JeanSOUDIER/PRG_GE2_HC/Mecanique/Vues/Sside2.JPG

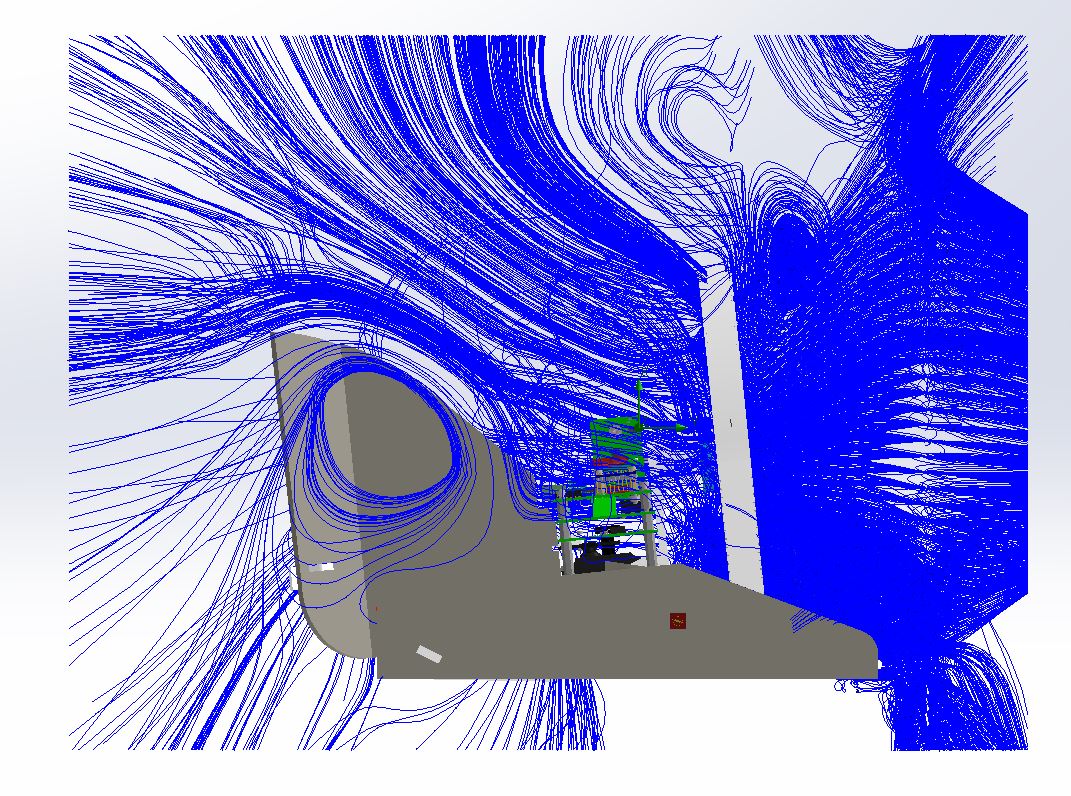
Mecanique/Vues/Sside2.JPG
