JeanSOUDIER/PRG_GE2_HC/Mecanique/Vues/poid.JPG

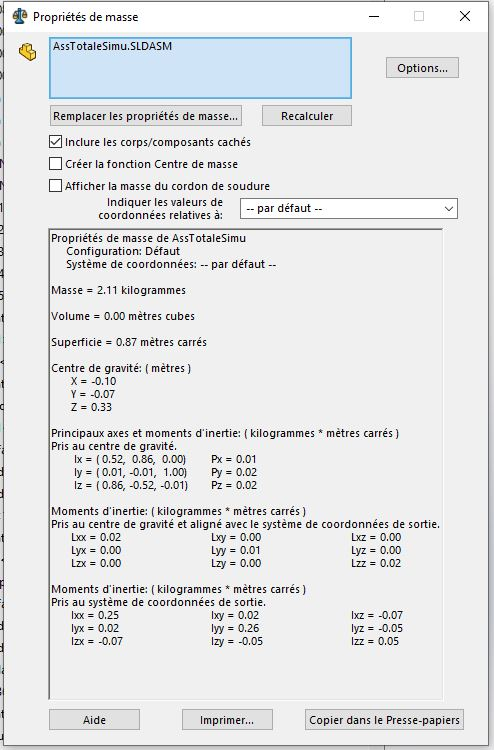
Mecanique/Vues/poid.JPG
