JeanSOUDIER/PRG_GE2_HC/Application/BackEnd1.PNG

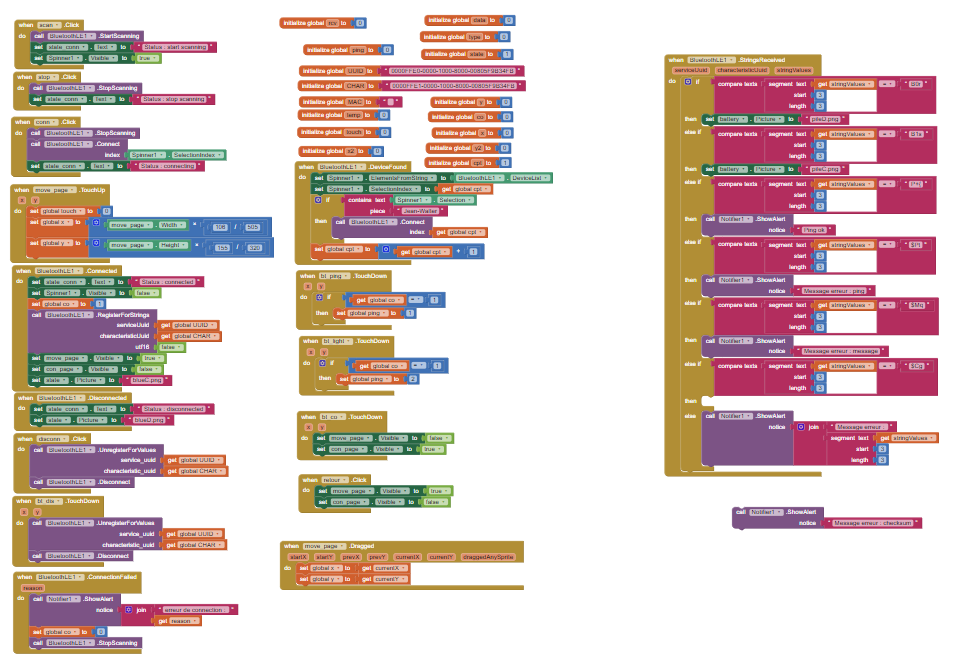
Application/BackEnd1.PNG
