JeanSOUDIER/PRG_GE2_HC/Application/BackEnd2.PNG

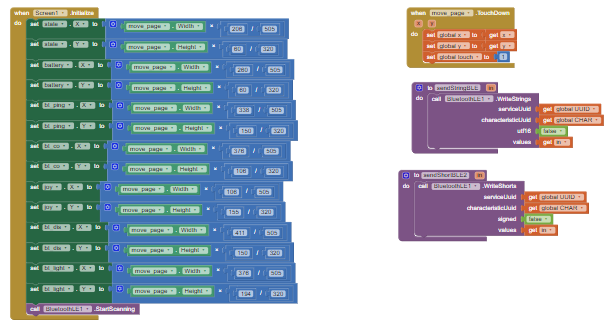
Application/BackEnd2.PNG
