JeanSOUDIER/PRG_GE2_HC/Application/BackEnd3.PNG

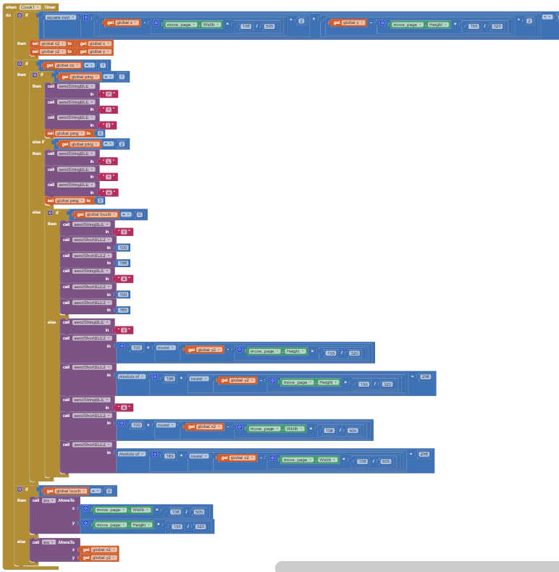
Application/BackEnd3.PNG
