JeanSOUDIER/PRG_GE2_HC/Application/FrontEnd.PNG

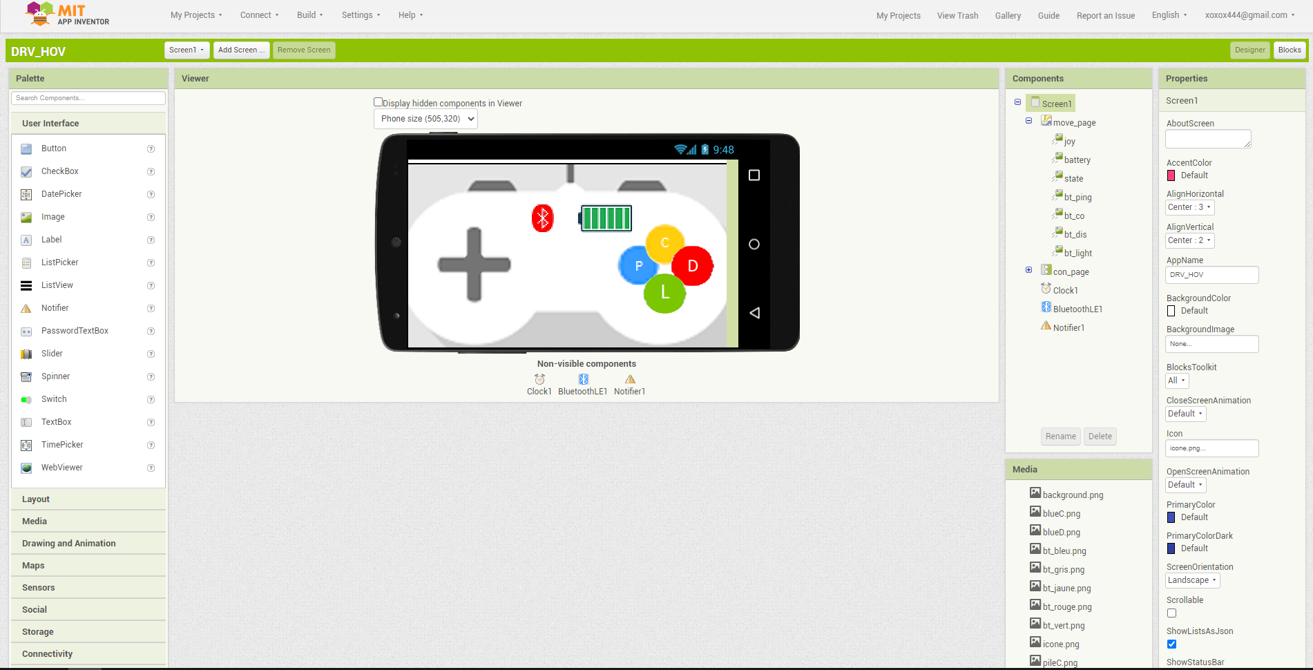
Application/FrontEnd.PNG
