JeanSOUDIER/PRG_GE2_HC/Mecanique/Vues/back.JPG

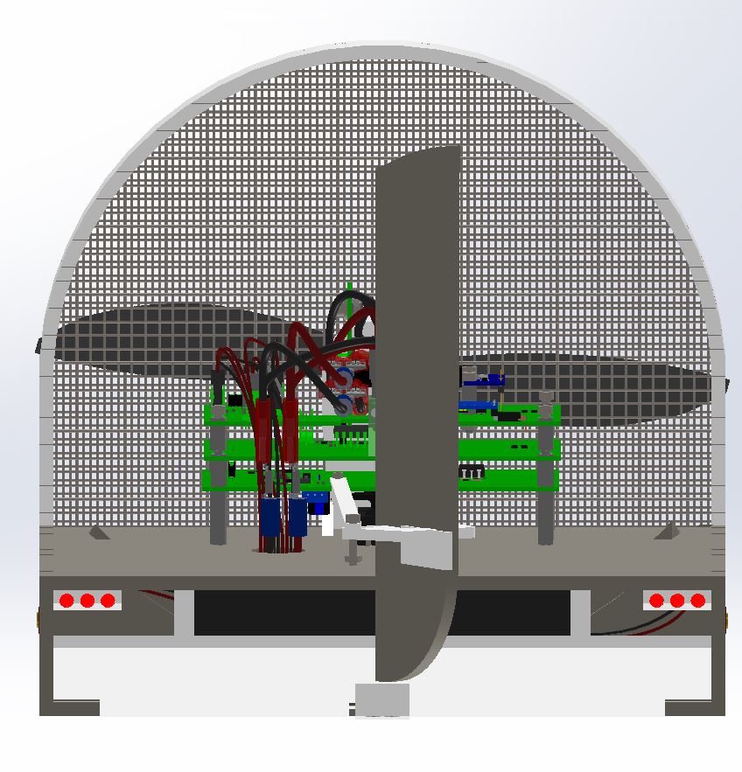
Mecanique/Vues/back.JPG
