JeanSOUDIER/PRG_GE2_HC/Mecanique/Vues/bottom.JPG

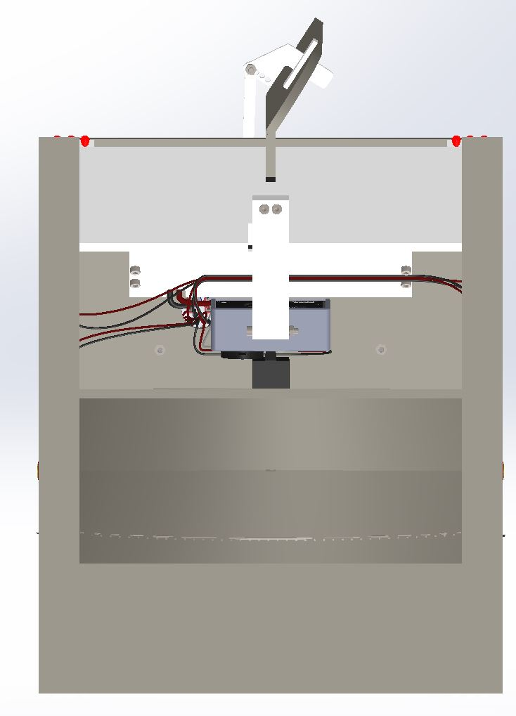
Mecanique/Vues/bottom.JPG
