JeanSOUDIER/PRG_GE2_HC/Mecanique/Vues/front.JPG

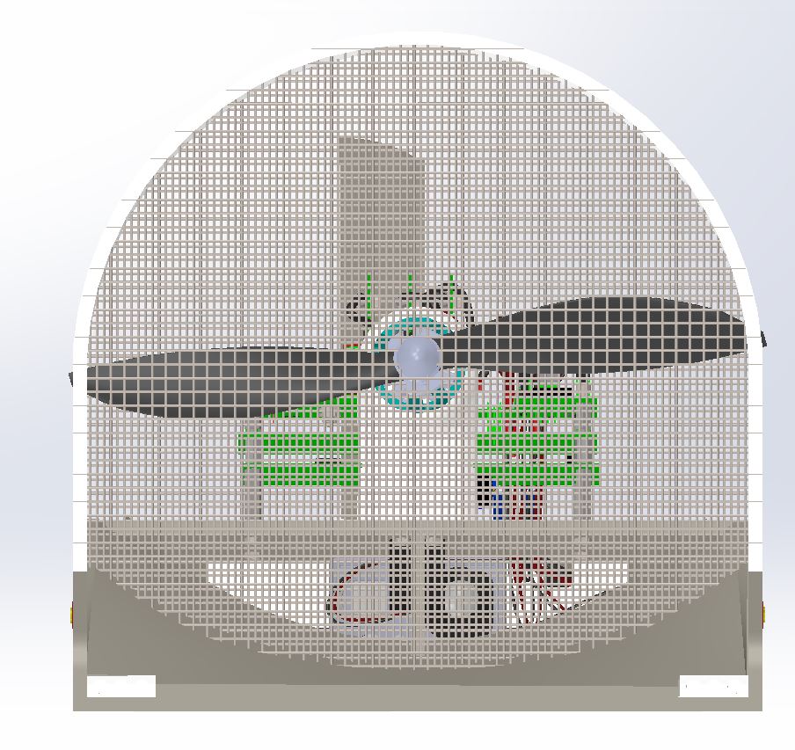
Mecanique/Vues/front.JPG
