JeanSOUDIER/PRG_GE2_HC/Mecanique/Vues/Gside.JPG

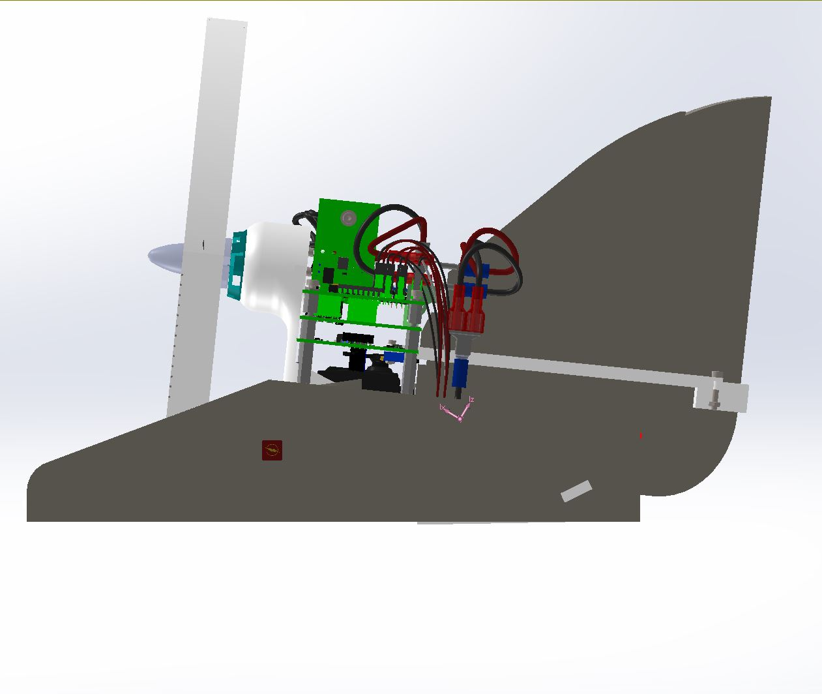
Mecanique/Vues/Gside.JPG
