JeanSOUDIER/PRG_GE2_HC/Mecanique/Vues/Gtop.JPG

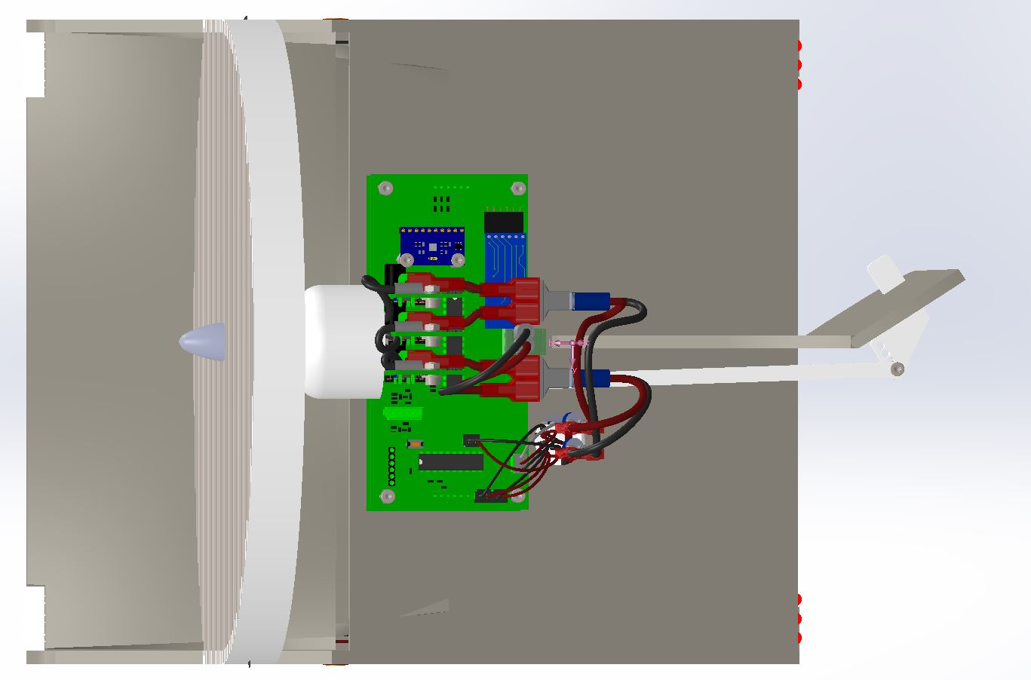
Mecanique/Vues/Gtop.JPG
