JeanSOUDIER/PRG_GE2_HC/Mecanique/Vues/S_bottom.JPG

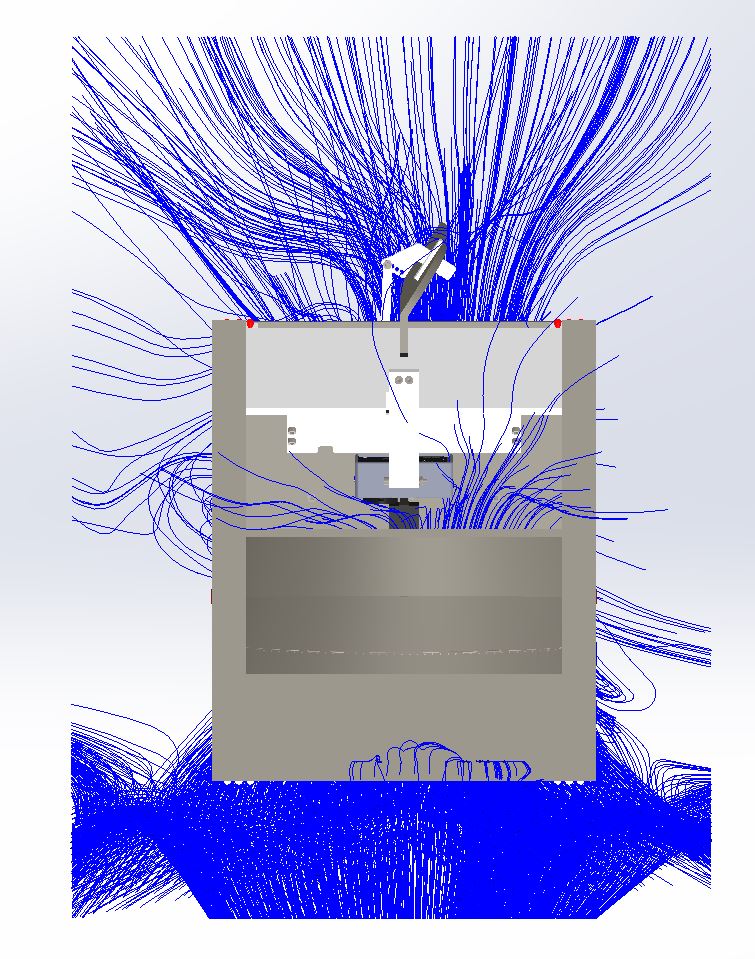
Mecanique/Vues/S_bottom.JPG
