JeanSOUDIER/PRG_GE2_HC/Mecanique/Vues/Sback.JPG

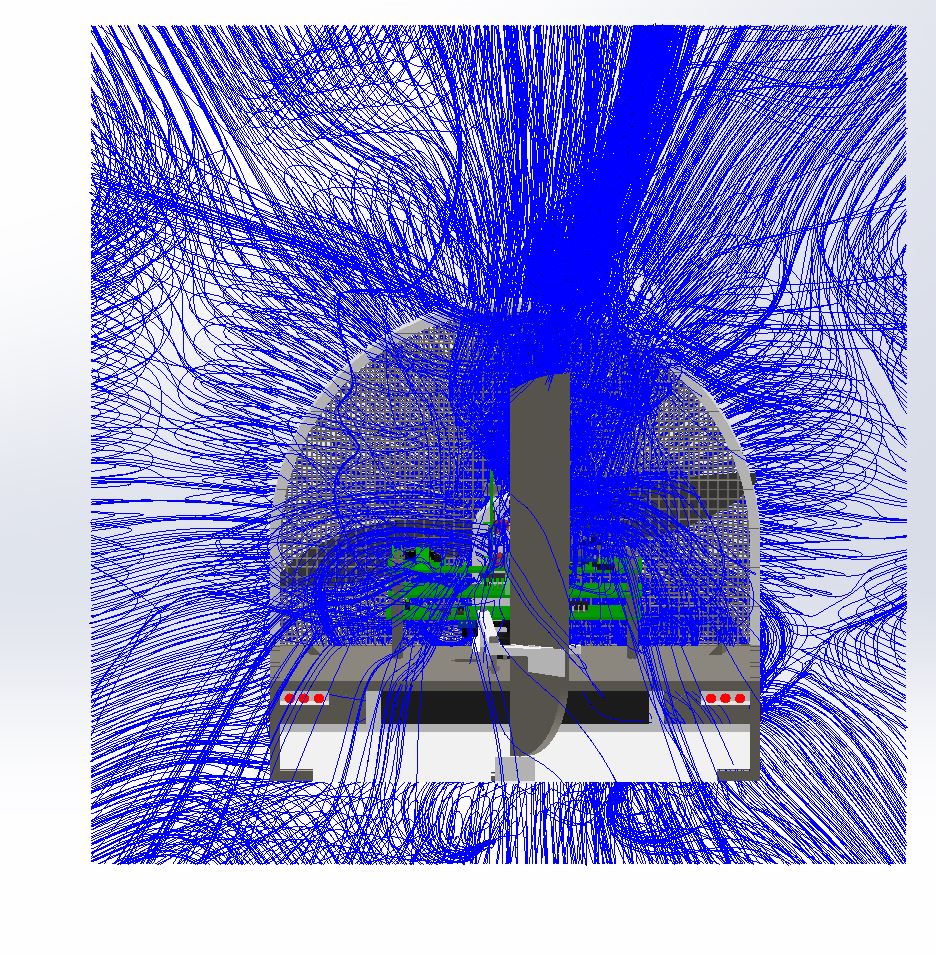
Mecanique/Vues/Sback.JPG
