JeanSOUDIER/PRG_GE2_HC/Mecanique/Vues/Sbackfull.JPG

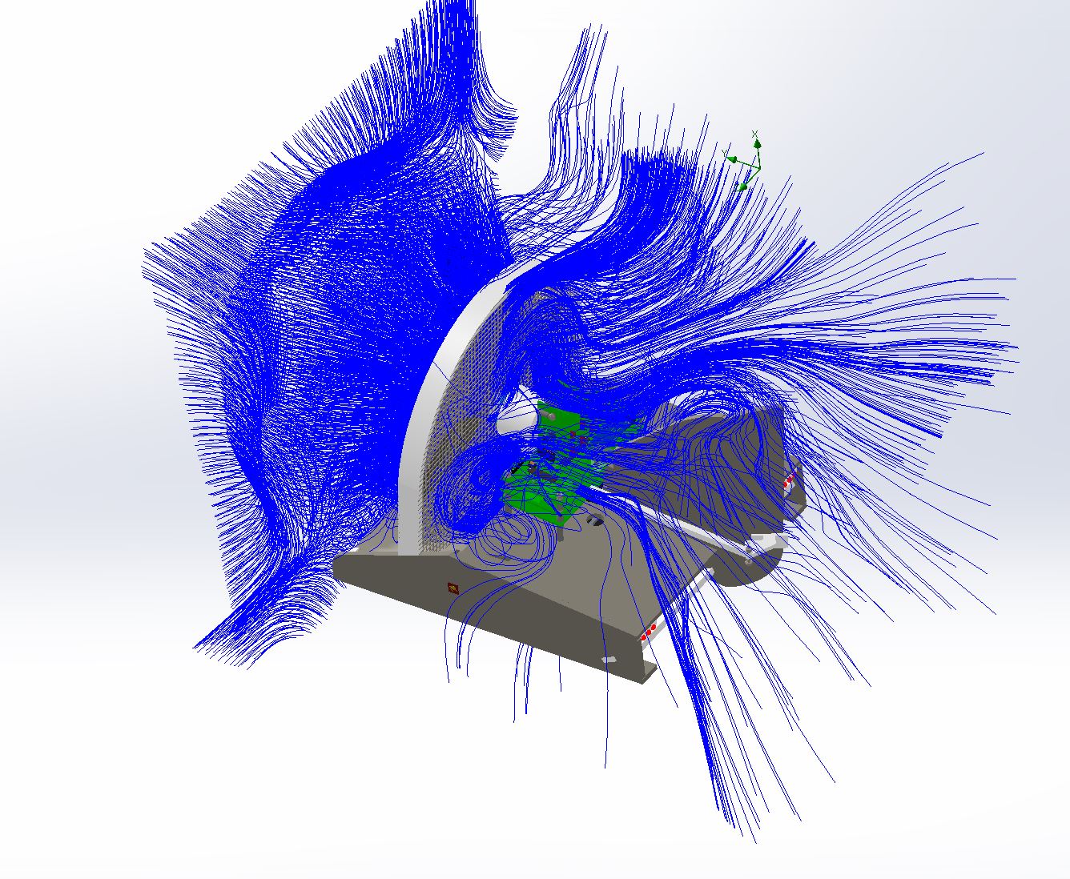
Mecanique/Vues/Sbackfull.JPG
