JeanSOUDIER/PRG_GE2_HC/Mecanique/Vues/Scard2.JPG

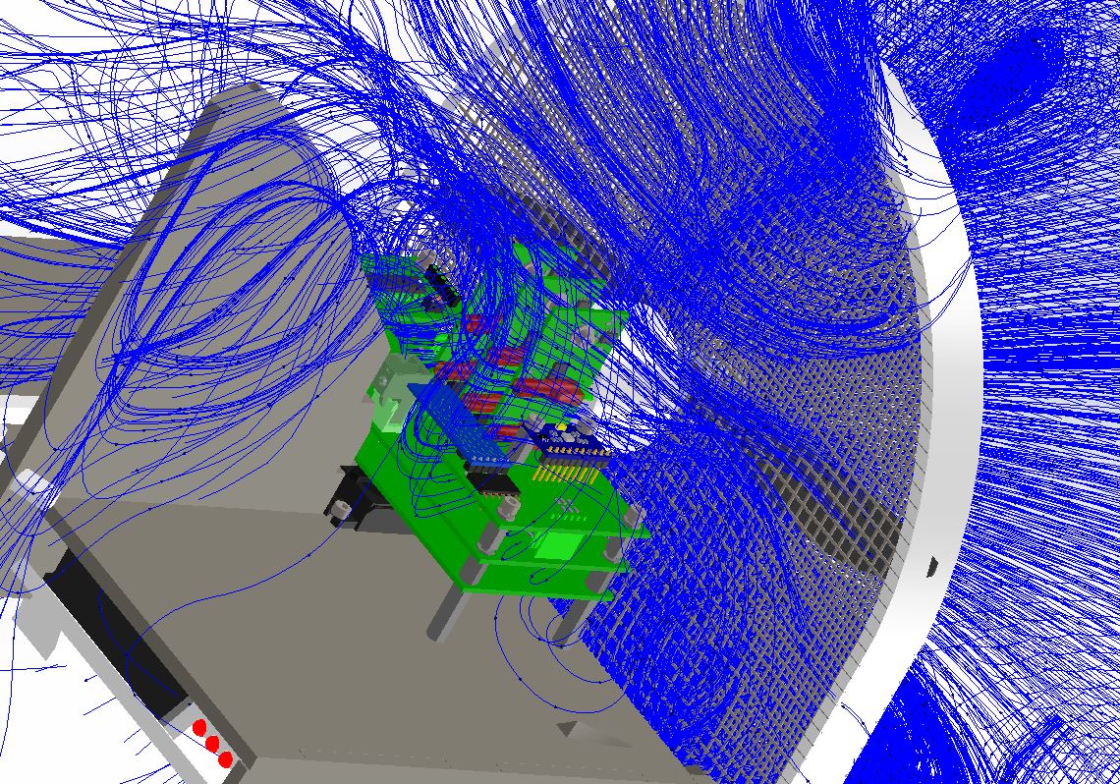
Mecanique/Vues/Scard2.JPG
