JeanSOUDIER/PRG_GE2_HC/Mecanique/Vues/Scard.JPG

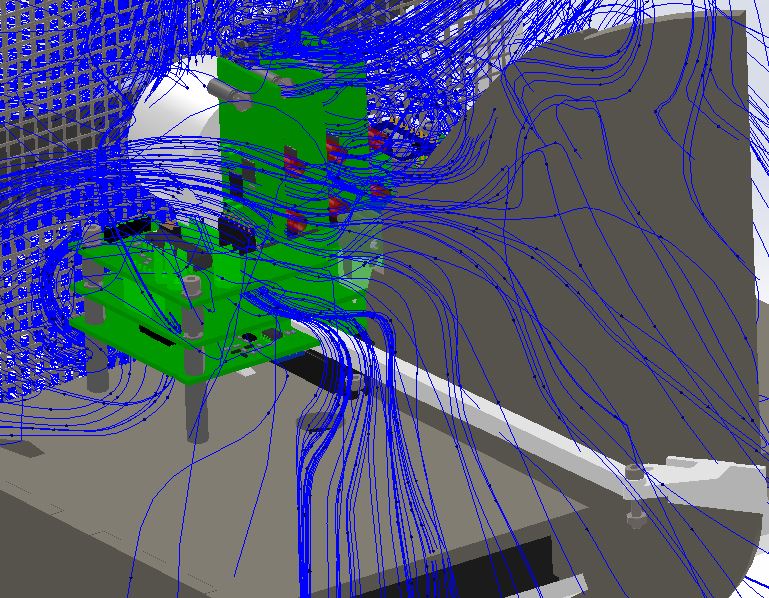
Mecanique/Vues/Scard.JPG
