JeanSOUDIER/PRG_GE2_HC/Mecanique/Vues/Sfront.JPG

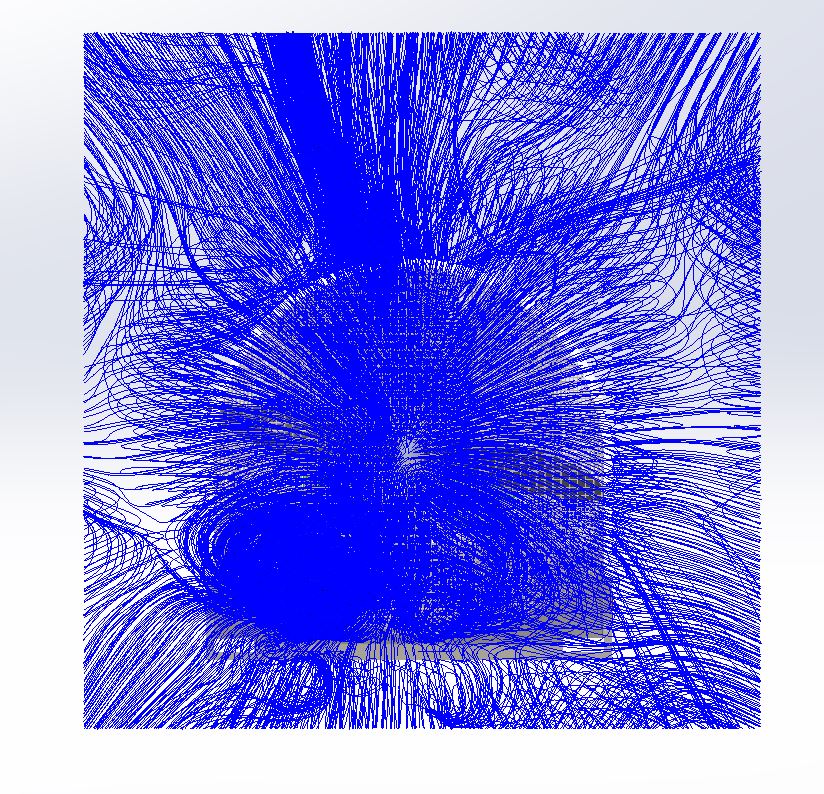
Mecanique/Vues/Sfront.JPG
