JeanSOUDIER/PRG_GE2_HC/Mecanique/Vues/Sfrontfull.JPG

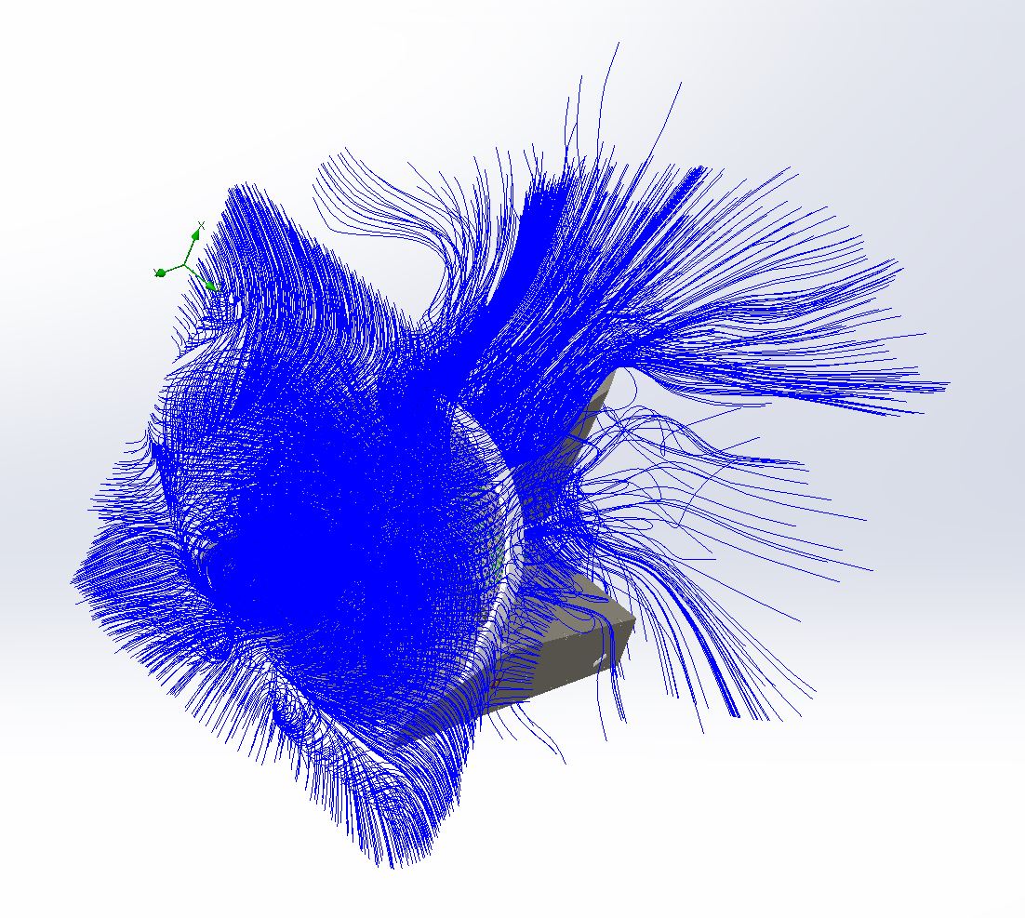
Mecanique/Vues/Sfrontfull.JPG
