JeanSOUDIER/PRG_GE2_HC/Mecanique/Vues/side2.JPG

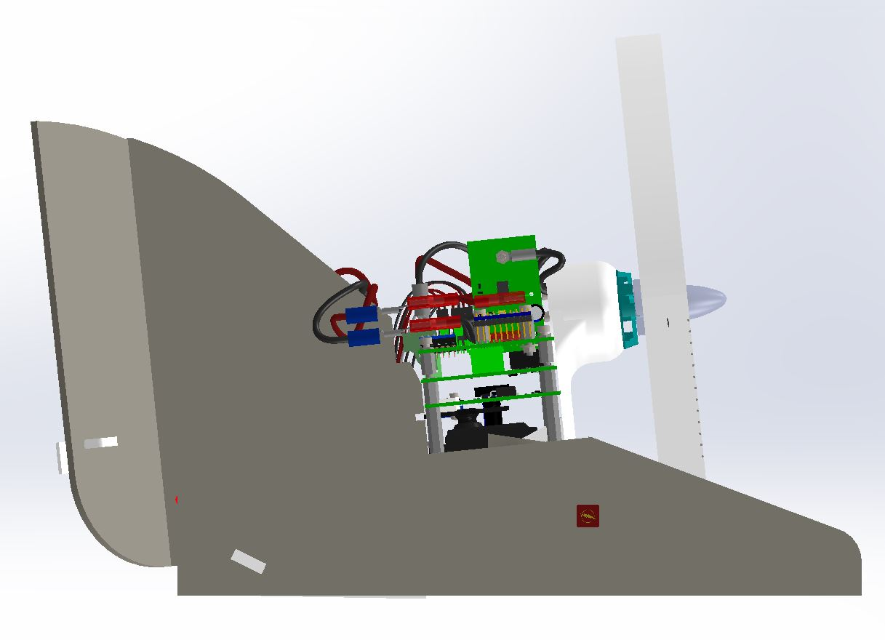
Mecanique/Vues/side2.JPG
