JeanSOUDIER/PRG_GE2_HC/Mecanique/Vues/side.JPG

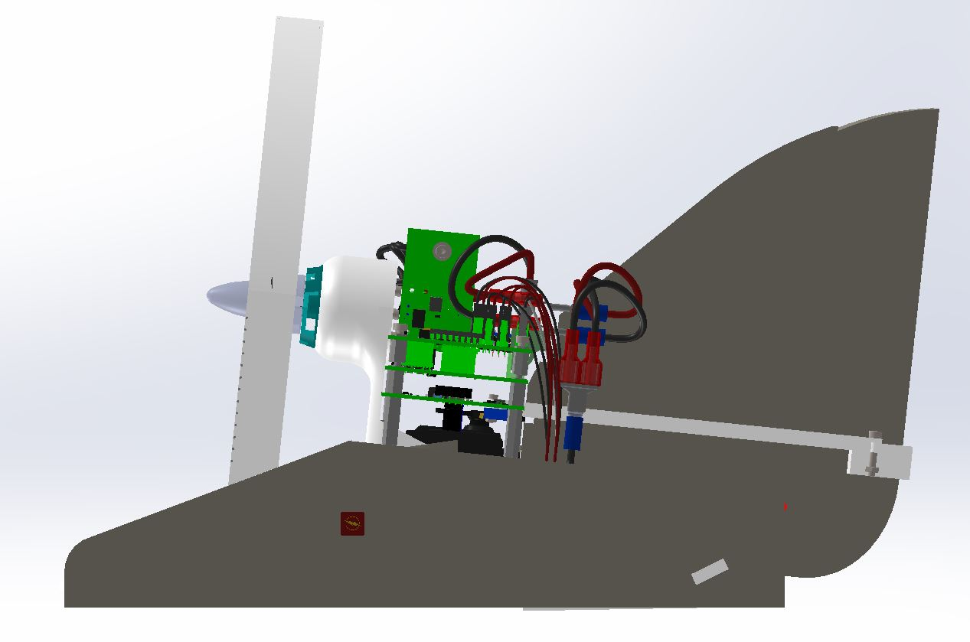
Mecanique/Vues/side.JPG
