JeanSOUDIER/PRG_GE2_HC/Mecanique/Vues/Sside1.JPG

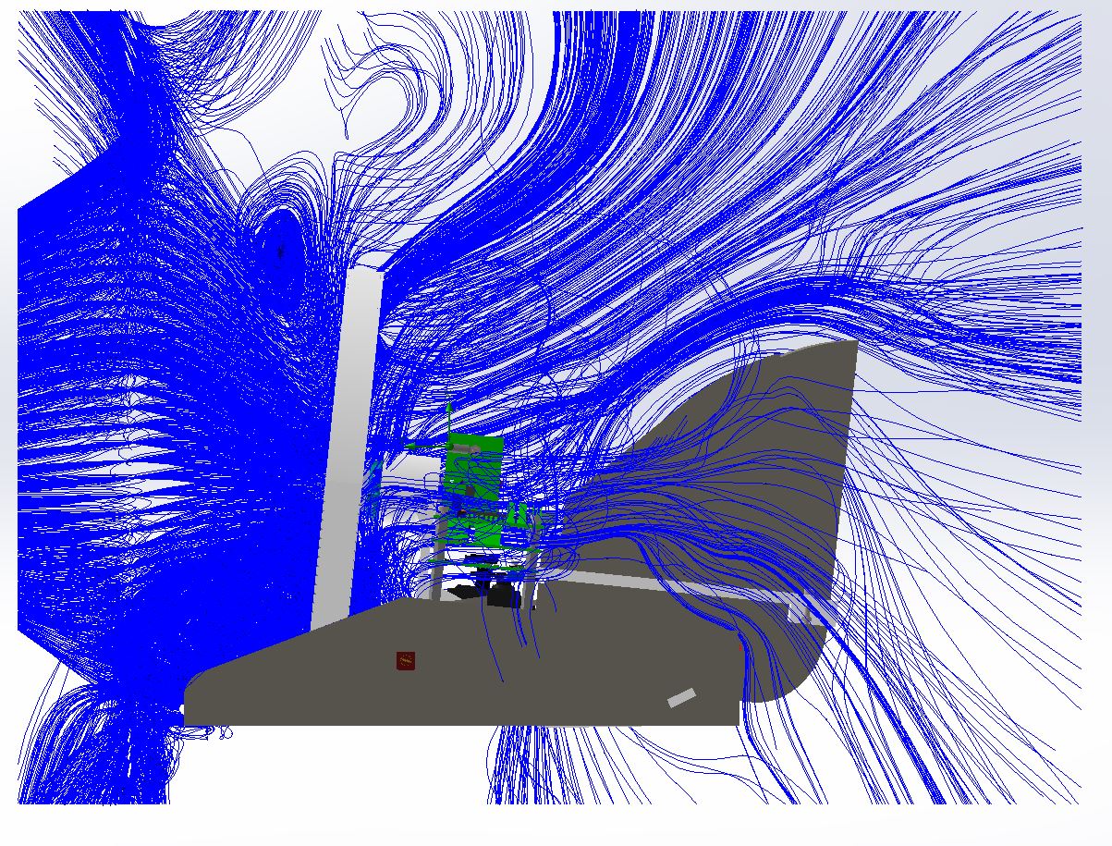
Mecanique/Vues/Sside1.JPG
