JeanSOUDIER/PRG_GE2_HC/Mecanique/Vues/Stop.JPG

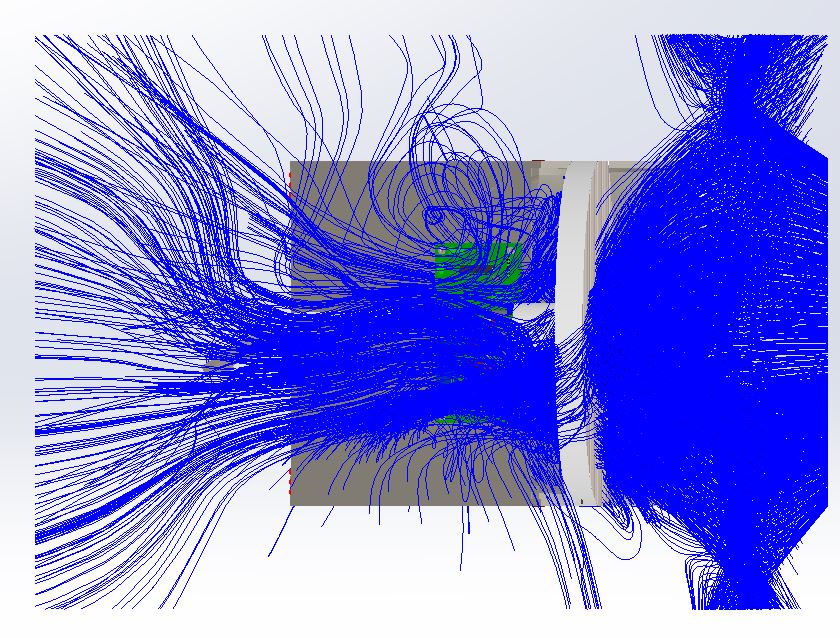
Mecanique/Vues/Stop.JPG
