JeanSOUDIER/PRG_GE2_HC/Mecanique/Vues/top.JPG

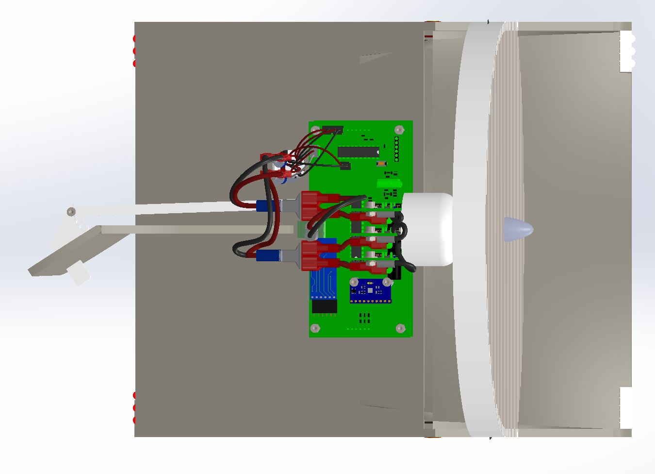
Mecanique/Vues/top.JPG
