JeanSOUDIER/PRG_GE2_HC/CAO_meca/hovercraft/AssTotale.SLDASM

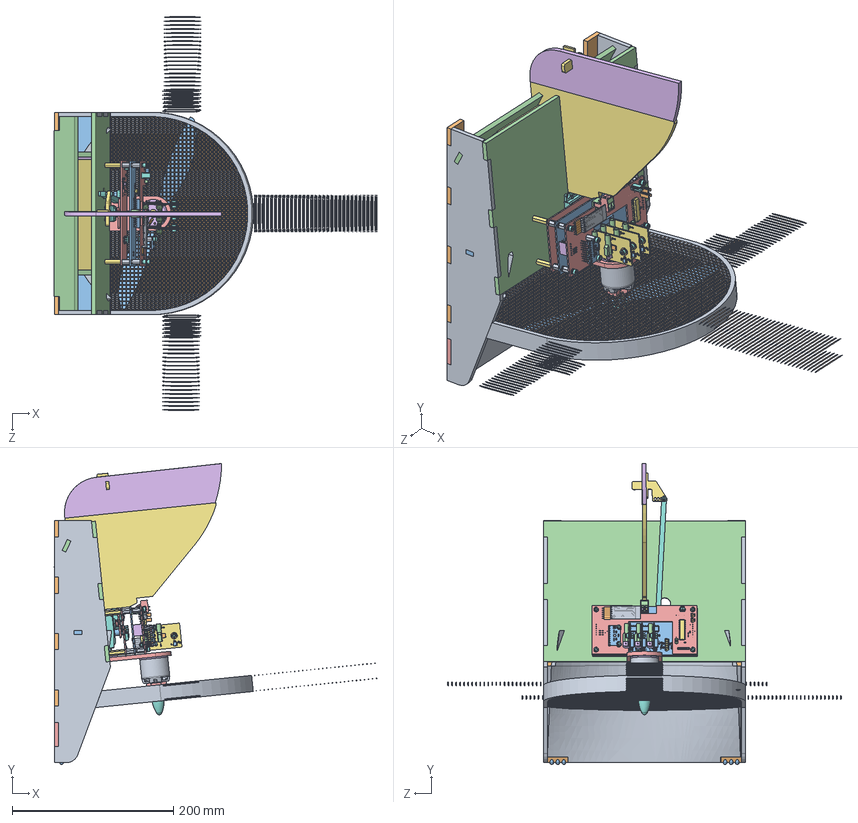
[picture p75: CAD file, 2020-04-15]
CAO_meca/hovercraft/AssTotale.SLDASM
400.3 x 373.2 x 488.5 mm
P1 x 2
P5 x 2
P7
P4
P3
P4b
battery
socket head cap screw 4762_din x 15
P11
piece_led x 2
LED 5mm x 6
P8
P12
P13
P10_2
Parallax-Servo_DUMMY
protec3c
barreau x 320
Layer_1
=_[0_1_1_3]
=_[0_1_1_4]
=_[0_1_1_5]
=_[0_1_1_3]_2 x 6
=_[0_1_1_4]_2 x 6
=_[0_1_1_5]_2 x 6
=_[0_1_1_6] x 6
=_[0_1_1_7] x 6
=_[0_1_1_8] x 6
=_[0_1_1_2] x 3
=_[0_1_1_60] x 3
=_[0_1_1_61] x 3
=_[0_1_1_62] x 3
=_[0_1_1_63] x 3
=_[0_1_1_64] x 3
=_[0_1_1_65] x 3
=_[0_1_1_66] x 3
=_[0_1_1_67] x 3
Pin_1 x 19
Pin_2 x 19
Pin_1_2 x 29
Pin_2_2 x 29
Imported
Imported_2
Imported_3
Imported_4
Imported_5
Imported_6
Imported_7
Imported_8
Imported_9
=_[0_1_1_3]_3
=_[0_1_1_4]_3
=_[0_1_1_5]_3
board_1
hole_plating_20 x 20
=_[0_1_1_77]
=_[0_1_1_79]
=_[0_1_1_80]
=_[0_1_1_81]
=_[0_1_1_82]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
