JeanSOUDIER/PRG_GE2_HC/Mecanique/Pieces_3D/AssLogo - logo2-1.STL

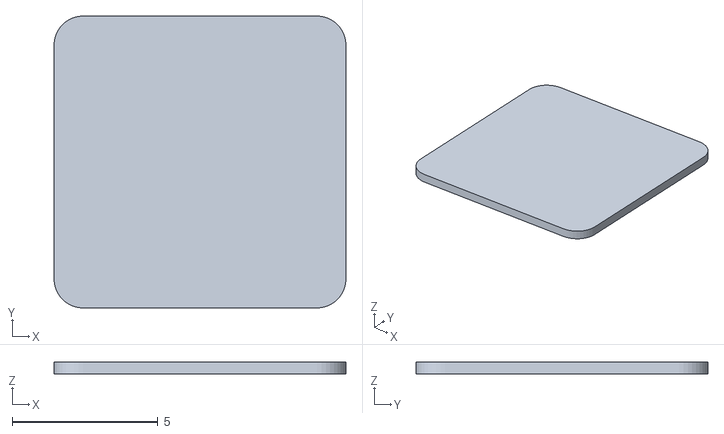
[picture p77: CAD file, 2020-04-27]
Mecanique/Pieces_3D/AssLogo - logo2-1.STL
10.00 x 10.00 x 0.4
