JeanSOUDIER/PRG_GE2_HC/pcb/carte_commande.STEP

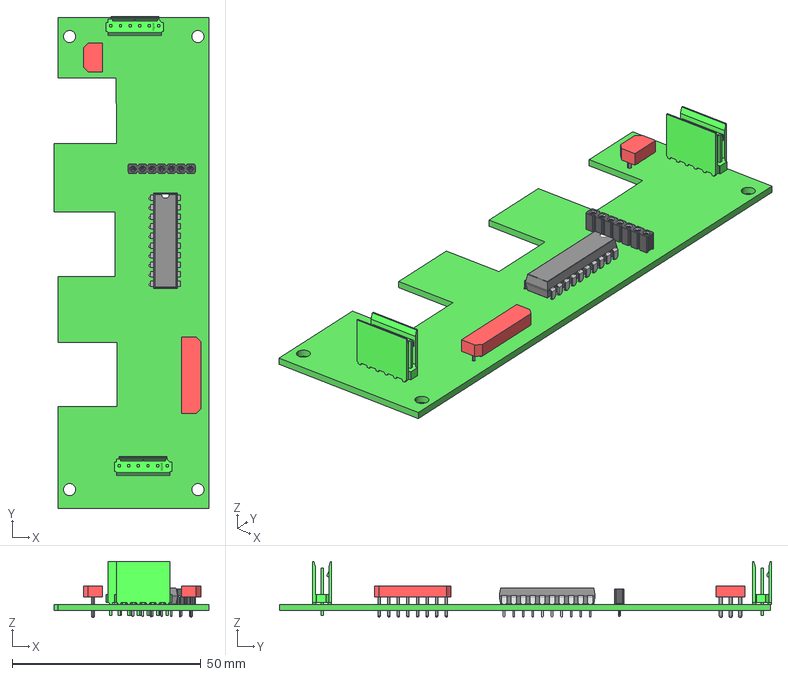
[picture p78: CAD file, 2020-03-29]
pcb/carte_commande.STEP
41.0 x 130.3 x 15.0 mm
Layer_1
Pin_1 x 2
Pin_2 x 2
Pin_3 x 2
Pin_4
Pin_5
Pin_6
Pin_7
Pin_8
