JeanSOUDIER/PRG_GE2_HC/Mecanique/Pieces_3D/AssLogo - logo1-1.STL

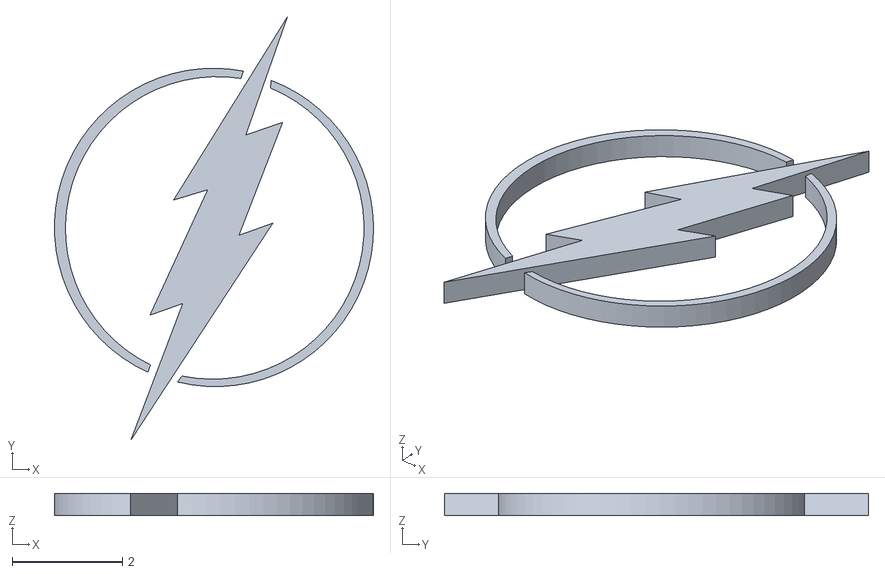
[picture p79: CAD file, 2020-04-27]
Mecanique/Pieces_3D/AssLogo - logo1-1.STL
5.80 x 7.71 x 0.4
