JeanSOUDIER/PRG_GE2_HC/Mecanique/Pieces_3D/piece_led.STL

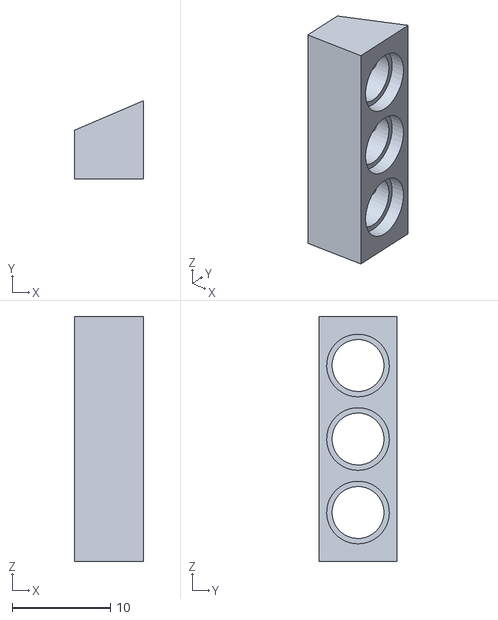
[picture p80: CAD file, 2020-04-27]
Mecanique/Pieces_3D/piece_led.STL
7.00 x 8.00 x 25.0
