JeanSOUDIER/PRG_GE2_HC/Mecanique/Pieces_3D/support2.STL

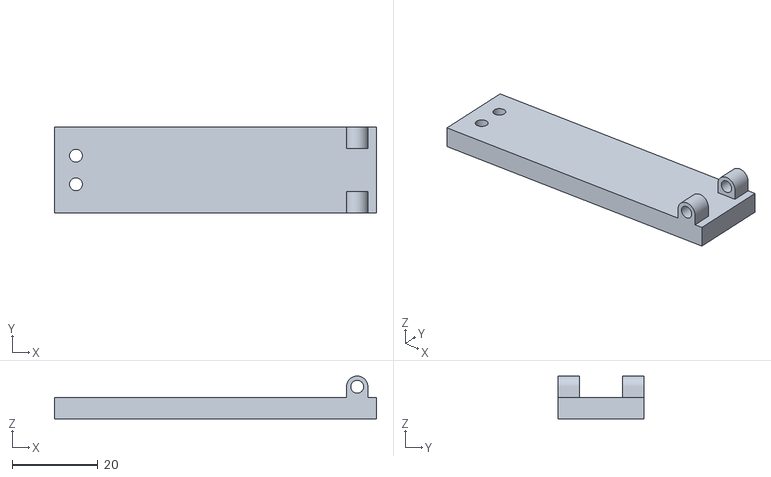
[picture p81: CAD file, 2020-04-27]
Mecanique/Pieces_3D/support2.STL
75.0 x 20.0 x 9.99
