JeanSOUDIER/PRG_GE2_HC/Mecanique/Pieces_3D/P4.STL

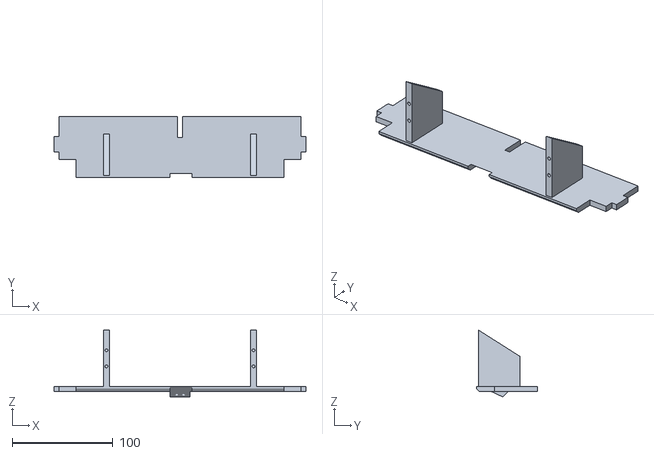
[picture p82: CAD file, 2020-04-27]
Mecanique/Pieces_3D/P4.STL
250.0 x 60.5 x 66.3
