JeanSOUDIER/PRG_GE2_HC/Mecanique/Pieces_3D/attache_pale.STL

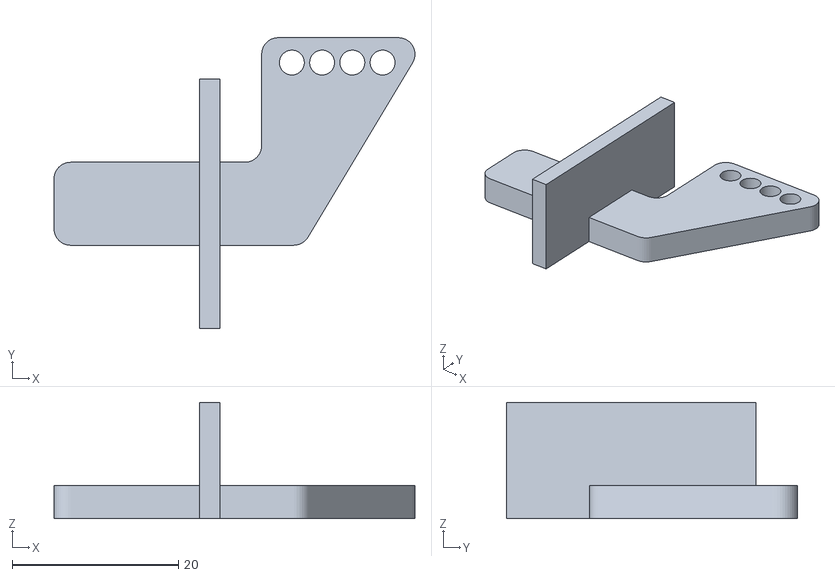
[picture p83: CAD file, 2020-04-27]
Mecanique/Pieces_3D/attache_pale.STL
43.5 x 35.0 x 14.0
