JeanSOUDIER/PRG_GE2_HC/Mecanique/Pieces_3D/P4b.STL

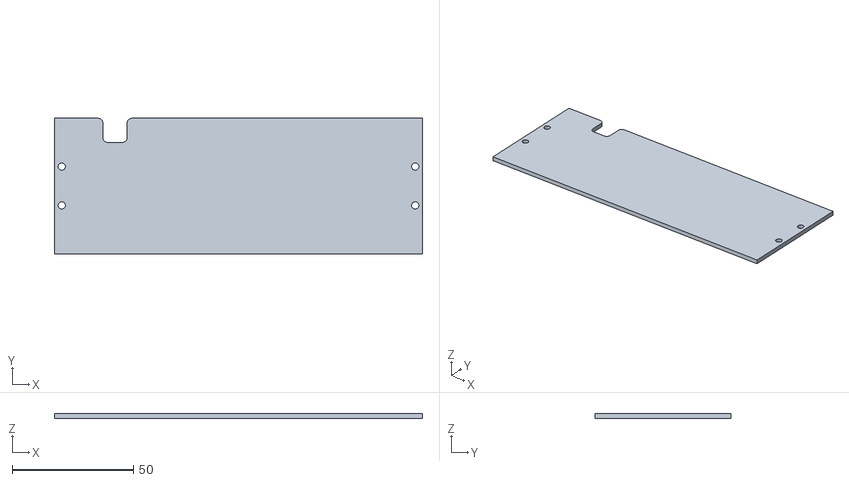
[picture p84: CAD file, 2020-04-27]
Mecanique/Pieces_3D/P4b.STL
152.0 x 56.0 x 2.00
