JeanSOUDIER/PRG_GE2_HC/Mecanique/Pieces_3D/protec3c.STL

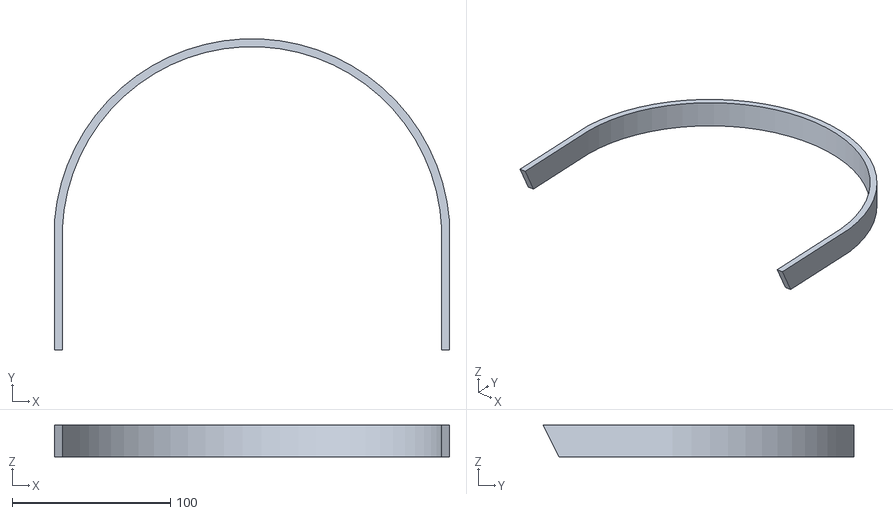
[picture p85: CAD file, 2020-04-27]
Mecanique/Pieces_3D/protec3c.STL
250.0 x 196.9 x 20.0
