JeanSOUDIER/PRG_GE2_HC/Mecanique/Pieces_3D/tige_servo.STL

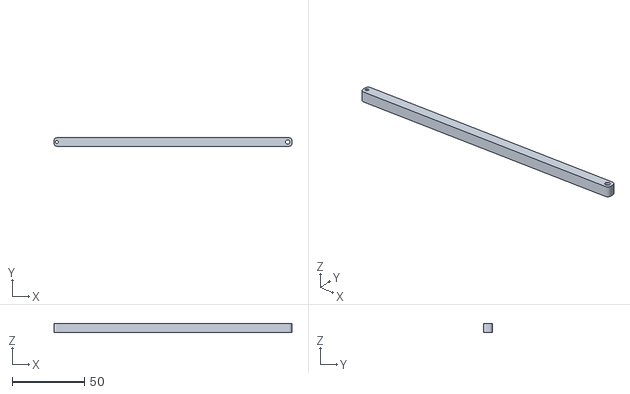
[picture p86: CAD file, 2020-04-27]
Mecanique/Pieces_3D/tige_servo.STL
165.0 x 6.00 x 6.00
