JeanSOUDIER/PRG_GE2_HC/Mecanique/Pieces_3D/P12.STL

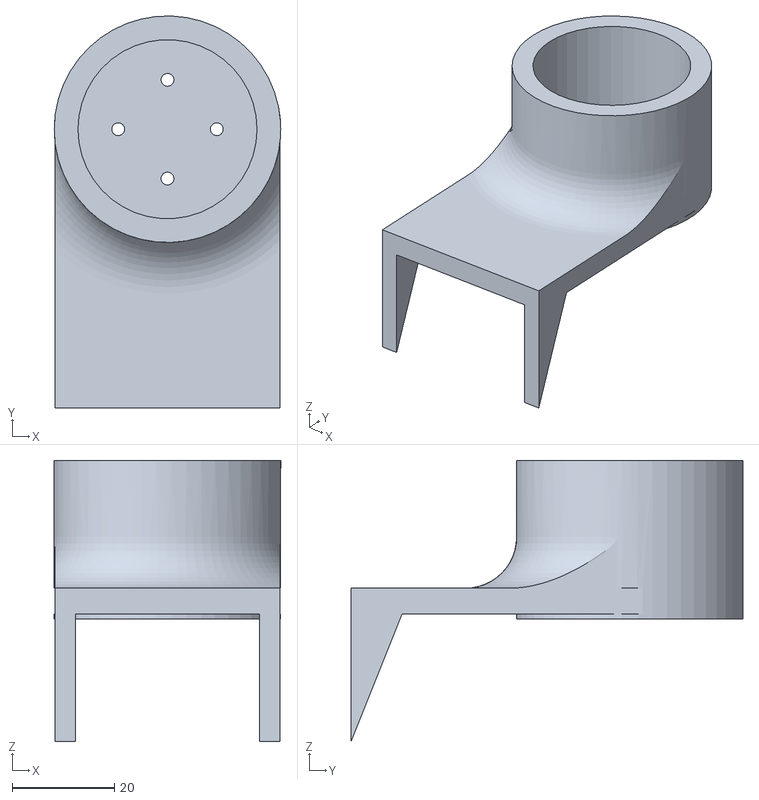
[picture p87: CAD file, 2020-04-27]
Mecanique/Pieces_3D/P12.STL
44.3 x 76.6 x 55.0
