JeanSOUDIER/PRG_GE2_HC/Mecanique/Pieces_3D/support1.STL

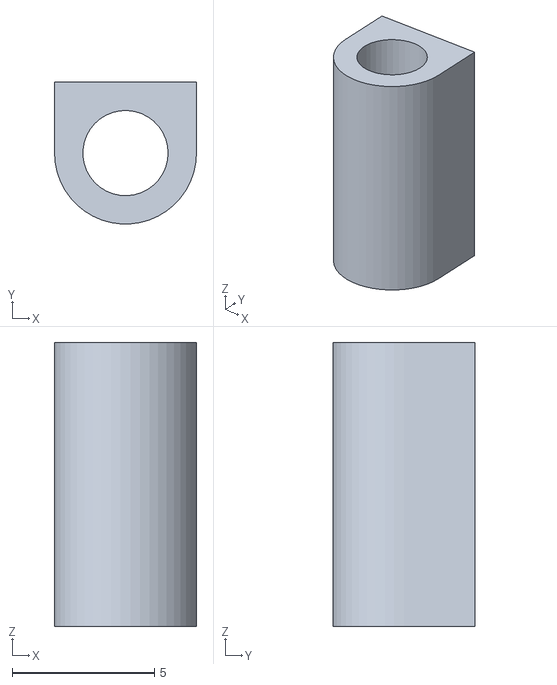
[picture p88: CAD file, 2020-04-27]
Mecanique/Pieces_3D/support1.STL
5.00 x 4.99 x 10.0
