JeanSOUDIER/PRG_GE2_HC/(list of files, cad)

Other CAD files:
Programmation/PIC.X/dist/default/production/PIC.X.production.obj
CAO_meca/STL/AssStructSimu.SLDPRT
CAO_meca/STL/AssStructSimu.STL
