JeanSOUDIER/PRG_GE2_HC/Mecanique/Mise_En_Plan/AssBase.pdf

# AssD

# AssG

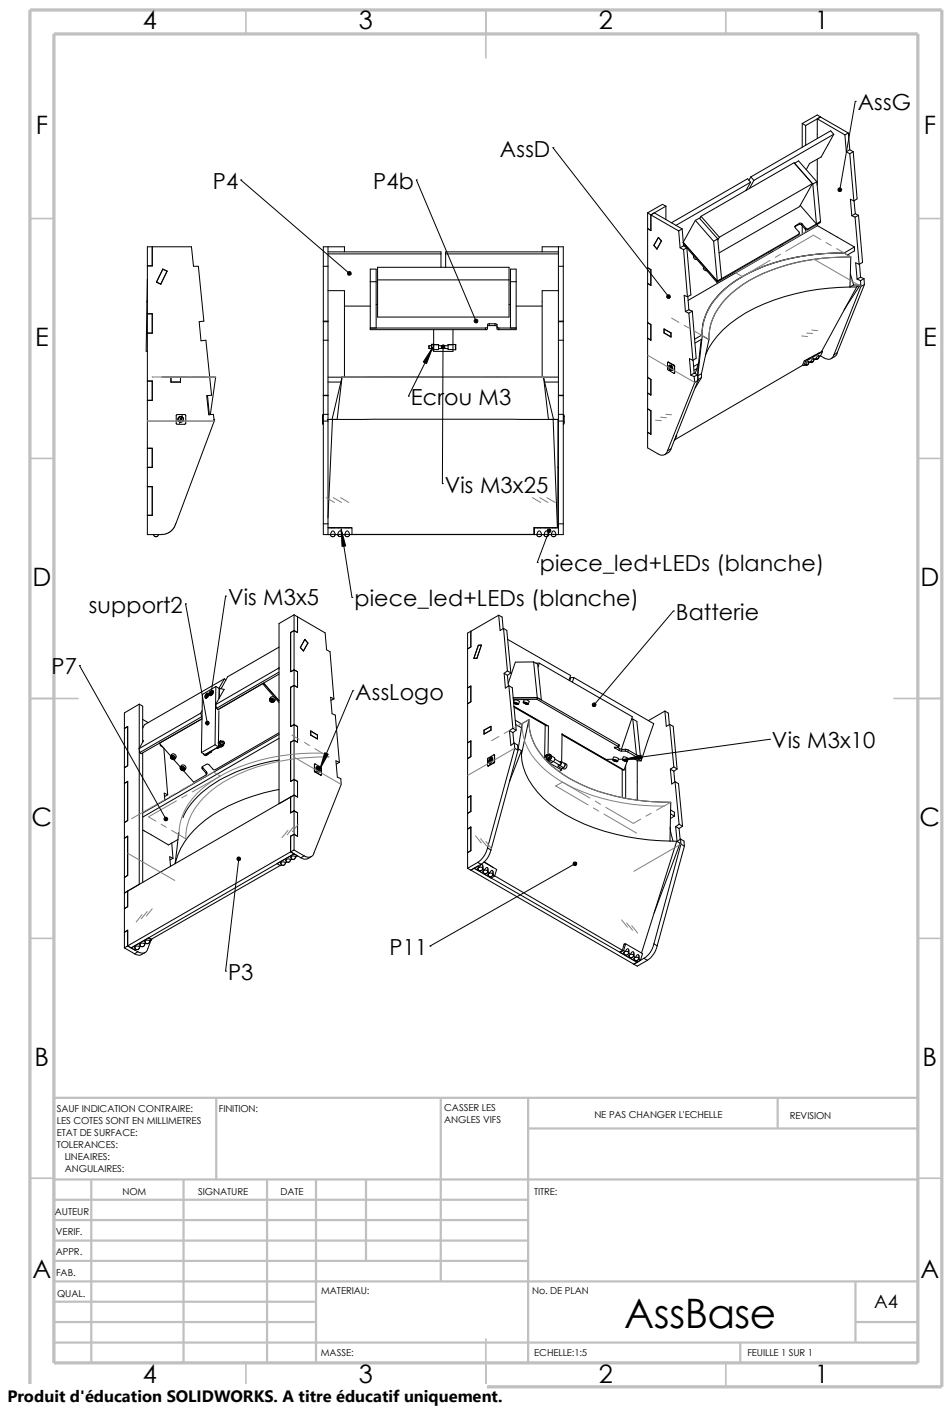
[picture p89: page 1]
Vis M3x25; Ecrou M3; piece_led+LEDs (blanche); MASSE:; FAB.; FEUILLE 1 SUR 1; ECHELLE:1:5; REVISION; QUAL.; FINITION:; ANGLES VIFS; MATERIAU:; CASSER LES; Batterie; Vis M3x10; Vis M3x5; AssLogo; support2

NE PAS CHANGER L'ECHELLE SAUF INDICATION CONTRAIRE:
LES COTES SONT EN MILLIMETRES
ETAT DE SURFACE:
TOLERANCES:
LINEAIRES:
ANGULAIRES:

NOM | SIGNATURE | DATE | TITRE:

AUTEUR
VERIF.
APPR.

No. DE PLAN
AssBase

Produit d'éducation SOLIDWORKS. A titre éducatif uniquement.
