JeanSOUDIER/PRG_GE2_HC/Mecanique/Mise_En_Plan/AssGouv.pdf

E E

F F

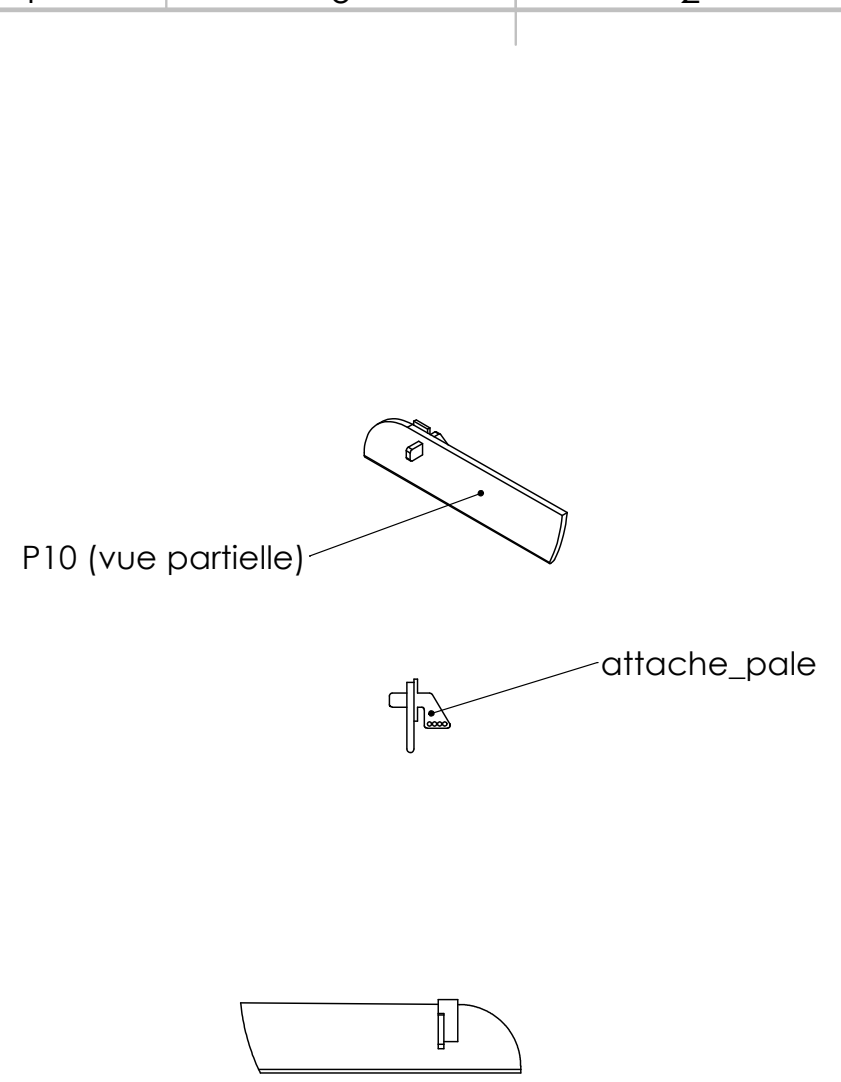
[picture p90: page 1]
MASSE:; FAB.; FEUILLE 1 SUR 1; ECHELLE:1:5; REVISION; QUAL.; FINITION:; ANGLES VIFS; MATERIAU:; CASSER LES; P10 (vue partielle); attache_pale

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

NOM | SIGNATURE | DATE | TITRE:

AUTEUR
VERIF.
APPR.

No. DE PLAN
AssGouv

Produit d'éducation SOLIDWORKS. A titre éducatif uniquement.
