JeanSOUDIER/PRG_GE2_HC/Mecanique/Mise_En_Plan/AssPhare.pdf

# piece_led

E E

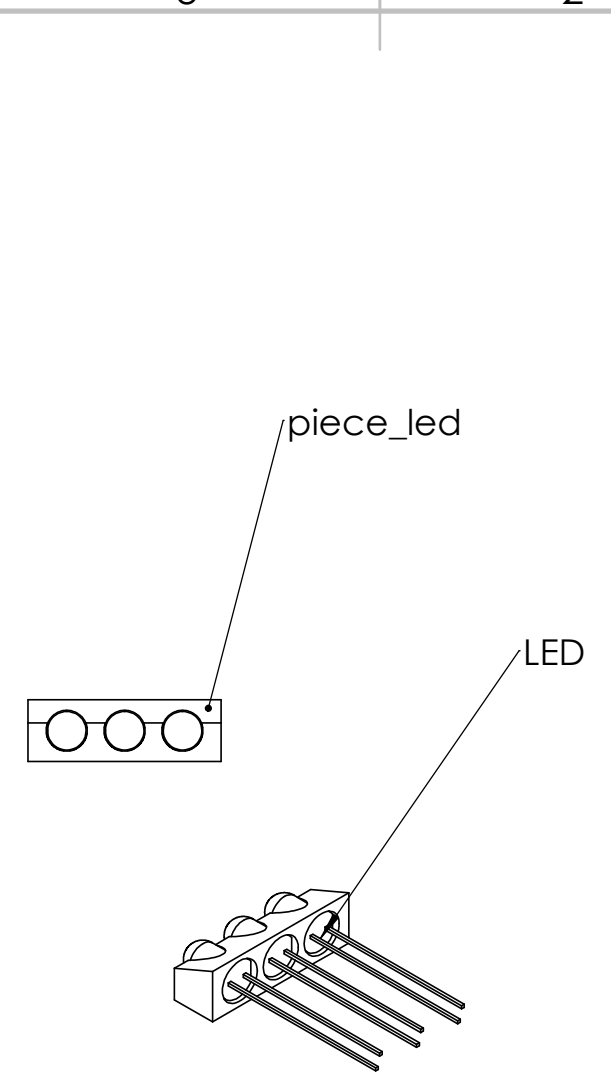
[picture p91: page 1]
MASSE:; FAB.; ECHELLE:1:1; FEUILLE 1 SUR 1; REVISION; QUAL.; FINITION:; ANGLES VIFS; MATERIAU:; CASSER LES; LED

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

NOM | SIGNATURE | DATE | TITRE:

AUTEUR
VERIF.
APPR.

No. DE PLAN
AssPhare

Produit d'éducation SOLIDWORKS. A titre éducatif uniquement.
