JeanSOUDIER/PRG_GE2_HC/Mecanique/Mise_En_Plan/AssToitMot.pdf

E E

F F

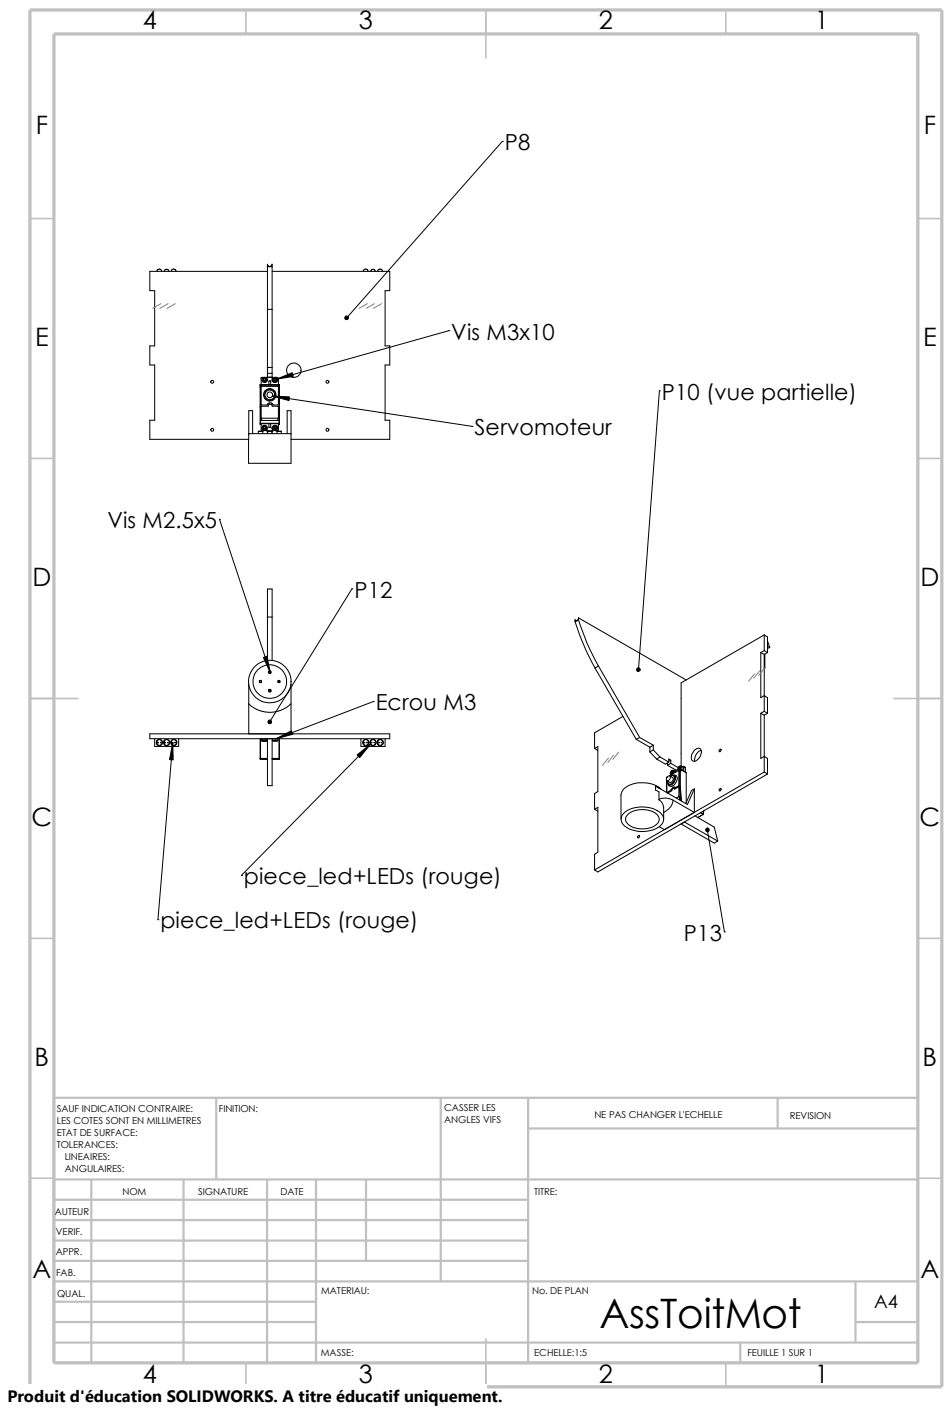
[picture p92: page 1]
ECHELLE:1:5; MASSE:; FEUILLE 1 SUR 1; NE PAS CHANGER L'ECHELLE; REVISION; MATERIAU:; FAB.; QUAL.; FINITION:; ANGLES VIFS; CASSER LES; Servomoteur; Vis M3x10; piece_led+LEDs (rouge); Ecrou M3; Vis M2.5x5; P10 (vue partielle)

SAUF INDICATION CONTRAIRE:
LES COTES SONT EN MILLIMETRES
ETAT DE SURFACE:
TOLERANCES:
LINEAIRES:
ANGULAIRES:

NOM | SIGNATURE | DATE | TITRE:

AUTEUR
VERIF.
APPR.

No. DE PLAN
AssToitMot

Produit d'éducation SOLIDWORKS. A titre éducatif uniquement.
