JeanSOUDIER/PRG_GE2_HC/Mecanique/Mise_En_Plan/AssTotal.pdf

E E

F F

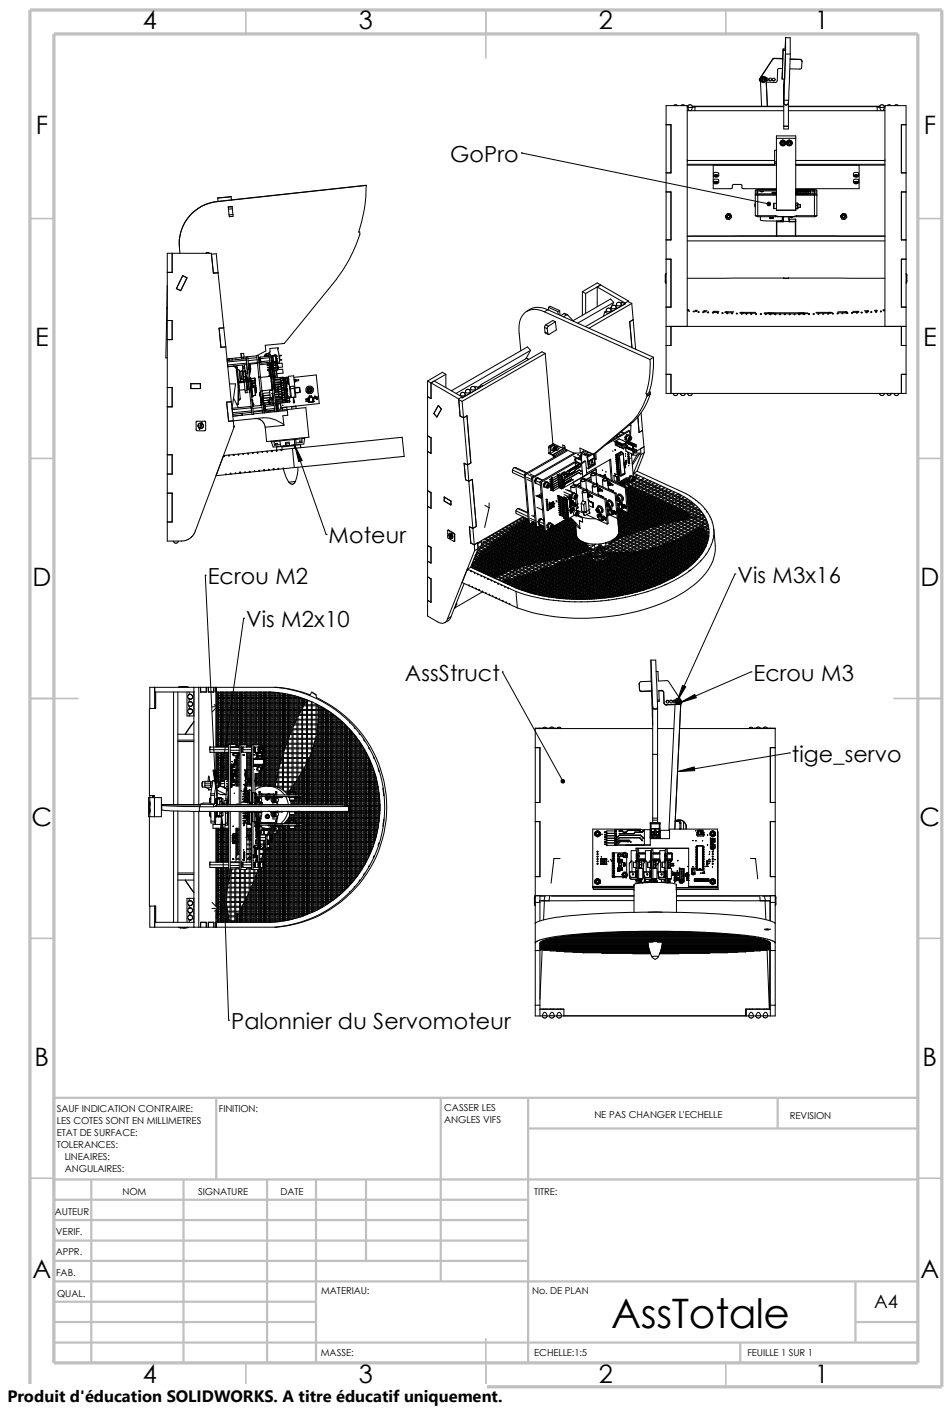
[picture p93: page 1]
Ecrou M2; Vis M2x10; MASSE:; FAB.; ECHELLE:1:5; FEUILLE 1 SUR 1; REVISION; QUAL.; FINITION:; ANGLES VIFS; MATERIAU:; CASSER LES; Moteur; Vis M3x16; AssStruct; tige_servo; Ecrou M3; GoPro

Palonnier du Servomoteur

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

NOM | SIGNATURE | DATE | TITRE:

AUTEUR
VERIF.
APPR.

No. DE PLAN
AssTotale

Produit d'éducation SOLIDWORKS. A titre éducatif uniquement.
