JeanSOUDIER/PRG_GE2_HC/Mecanique/Mise_En_Plan/P7.pdf

E E

F F

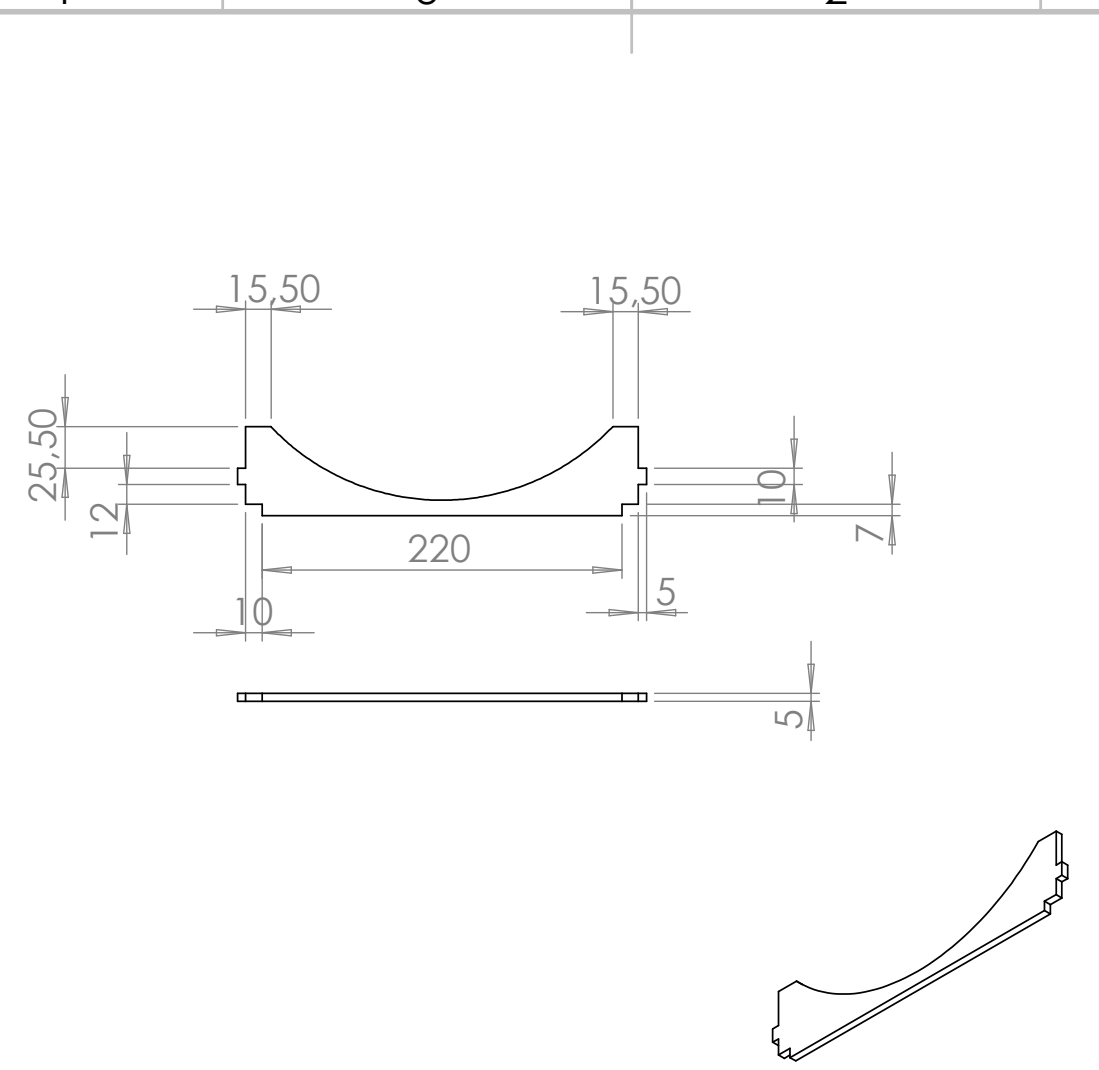
[picture p94: page 1]
ECHELLE:1:5; FEUILLE 1 SUR 1; MASSE:; MATERIAU:; REVISION; FAB.; QUAL.; FINITION:; ANGLES VIFS; CASSER LES

SAUF INDICATION CONTRAIRE:
LES COTES SONT EN MILLIMETRES
ETAT DE SURFACE:
TOLERANCES:
LINEAIRES:
ANGULAIRES:

NE PAS CHANGER L'ECHELLE

NOM | SIGNATURE | DATE | TITRE:

AUTEUR
VERIF.
APPR.

No. DE PLAN

Produit d'éducation SOLIDWORKS. A titre éducatif uniquement.
