JeanSOUDIER/PRG_GE2_HC/Mecanique/Mise_En_Plan/P8.pdf

E E

F F

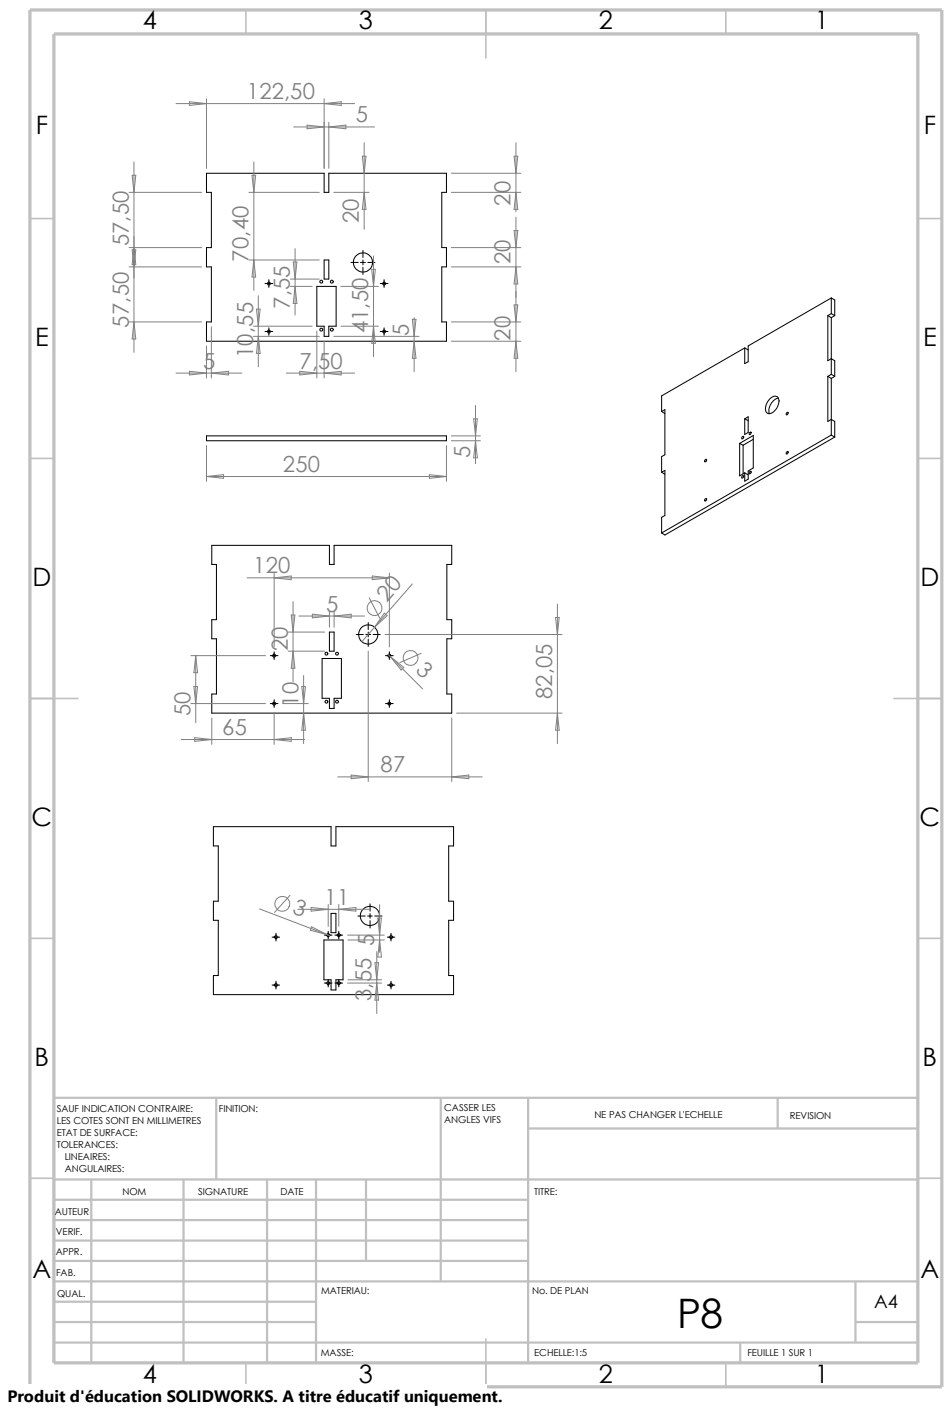
[picture p95: page 1]
ECHELLE:1:5; MASSE:; FEUILLE 1 SUR 1; NE PAS CHANGER L'ECHELLE; REVISION; FAB.; QUAL.; FINITION:; ANGLES VIFS; MATERIAU:; CASSER LES

SAUF INDICATION CONTRAIRE:
LES COTES SONT EN MILLIMETRES
ETAT DE SURFACE:
TOLERANCES:
LINEAIRES:
ANGULAIRES:

NOM | SIGNATURE | DATE | TITRE:

AUTEUR
VERIF.
APPR.

No. DE PLAN

Produit d'éducation SOLIDWORKS. A titre éducatif uniquement.
