JeanSOUDIER/PRG_GE2_HC/Mecanique/Mise_En_Plan/AssCarte.pdf

E E

F F

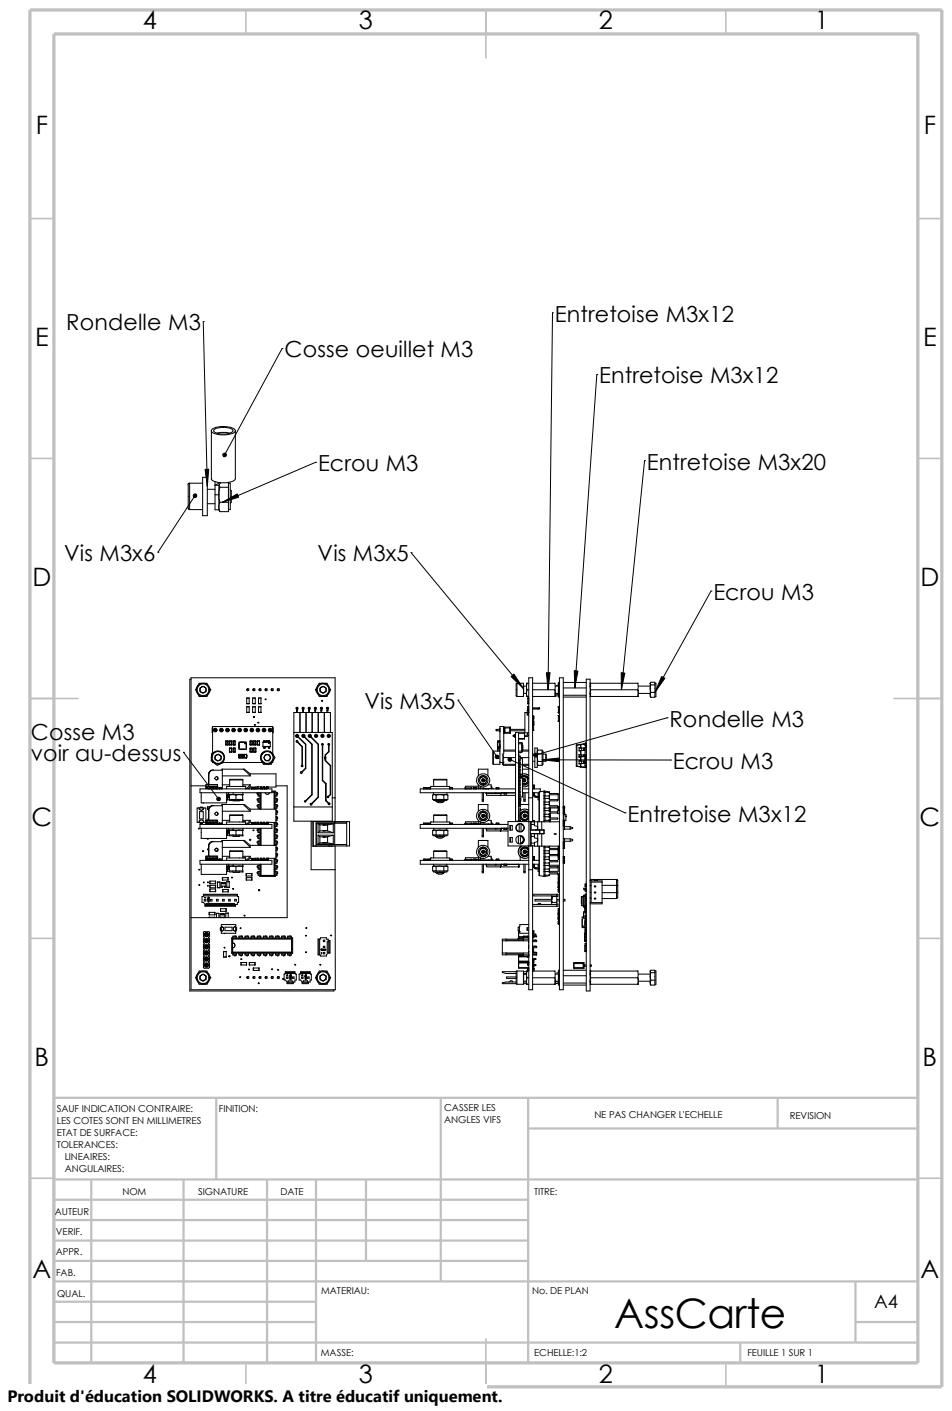
[picture p96: page 1]
MASSE:; FAB.; ECHELLE:1:2; FEUILLE 1 SUR 1; REVISION; QUAL.; FINITION:; ANGLES VIFS; MATERIAU:; CASSER LES; Cosse oeuillet M3; Ecrou M3; Rondelle M3; Vis M3x6; Entretoise M3x12; Entretoise M3x20; Vis M3x5

Cosse M3
voir au-dessus

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

NOM | SIGNATURE | DATE | TITRE:

AUTEUR
VERIF.
APPR.

No. DE PLAN
AssCarte

Produit d'éducation SOLIDWORKS. A titre éducatif uniquement.
