JeanSOUDIER/PRG_GE2_HC/Mecanique/Mise_En_Plan/AssD.pdf

P1

P5

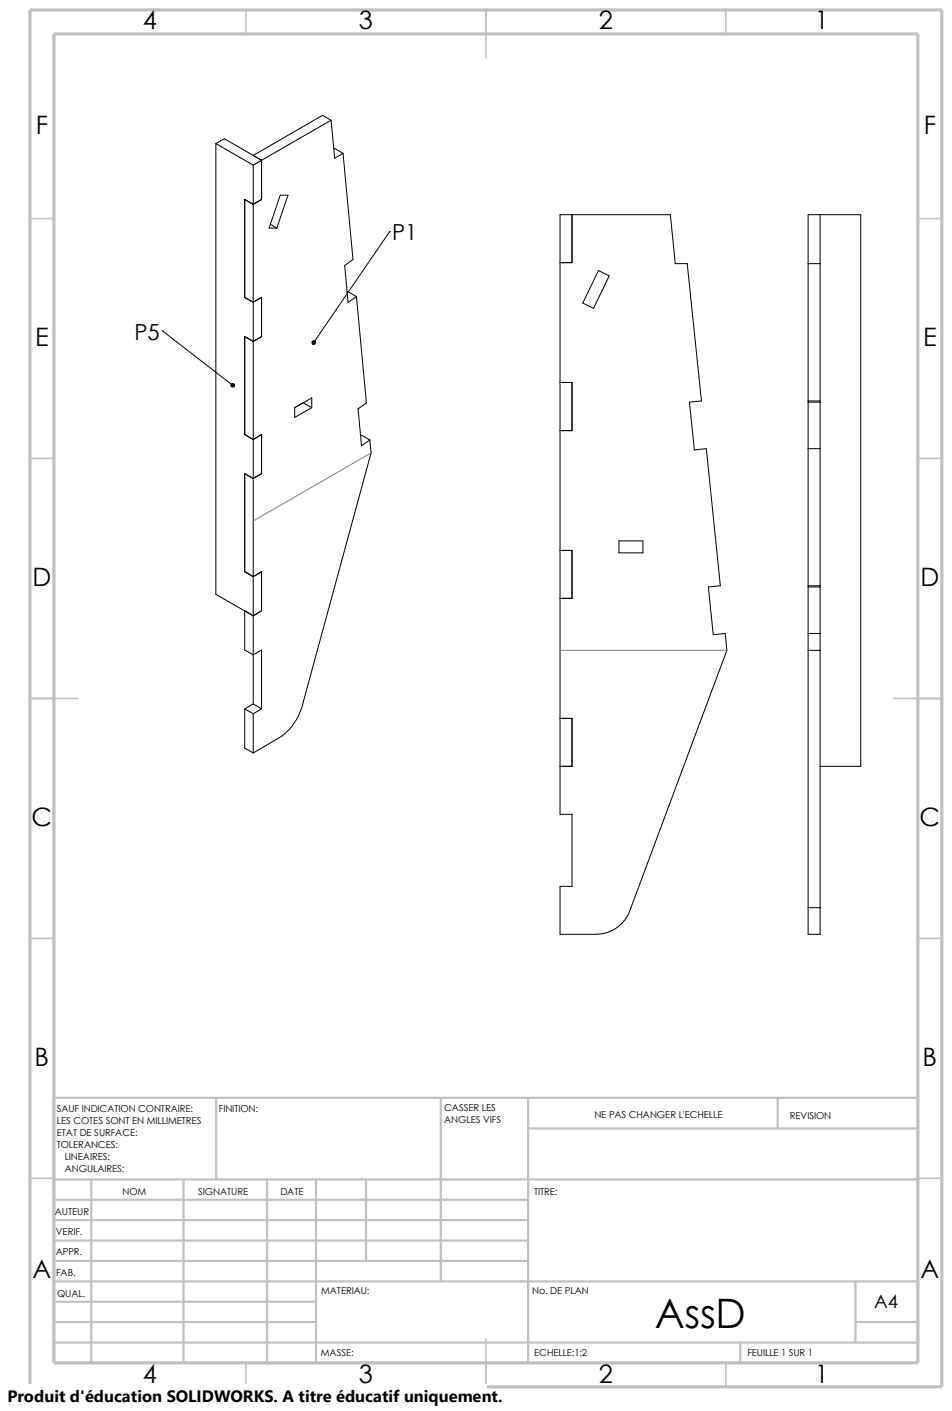
[picture p97: page 1]
REVISION; ECHELLE:1:2; FEUILLE 1 SUR 1; MASSE:; MATERIAU:; No. DE PLAN; FAB.; QUAL.; FINITION:; ANGLES VIFS; CASSER LES; AssD

SAUF INDICATION CONTRAIRE:
LES COTES SONT EN MILLIMETRES
ETAT DE SURFACE:
TOLERANCES:
LINEAIRES:
ANGULAIRES:

NE PAS CHANGER L'ECHELLE

NOM | SIGNATURE | DATE | TITRE:

AUTEUR
VERIF.
APPR.

Produit d'éducation SOLIDWORKS. A titre éducatif uniquement.
