JeanSOUDIER/PRG_GE2_HC/Mecanique/Mise_En_Plan/AssG.pdf

P5 | P1

E E

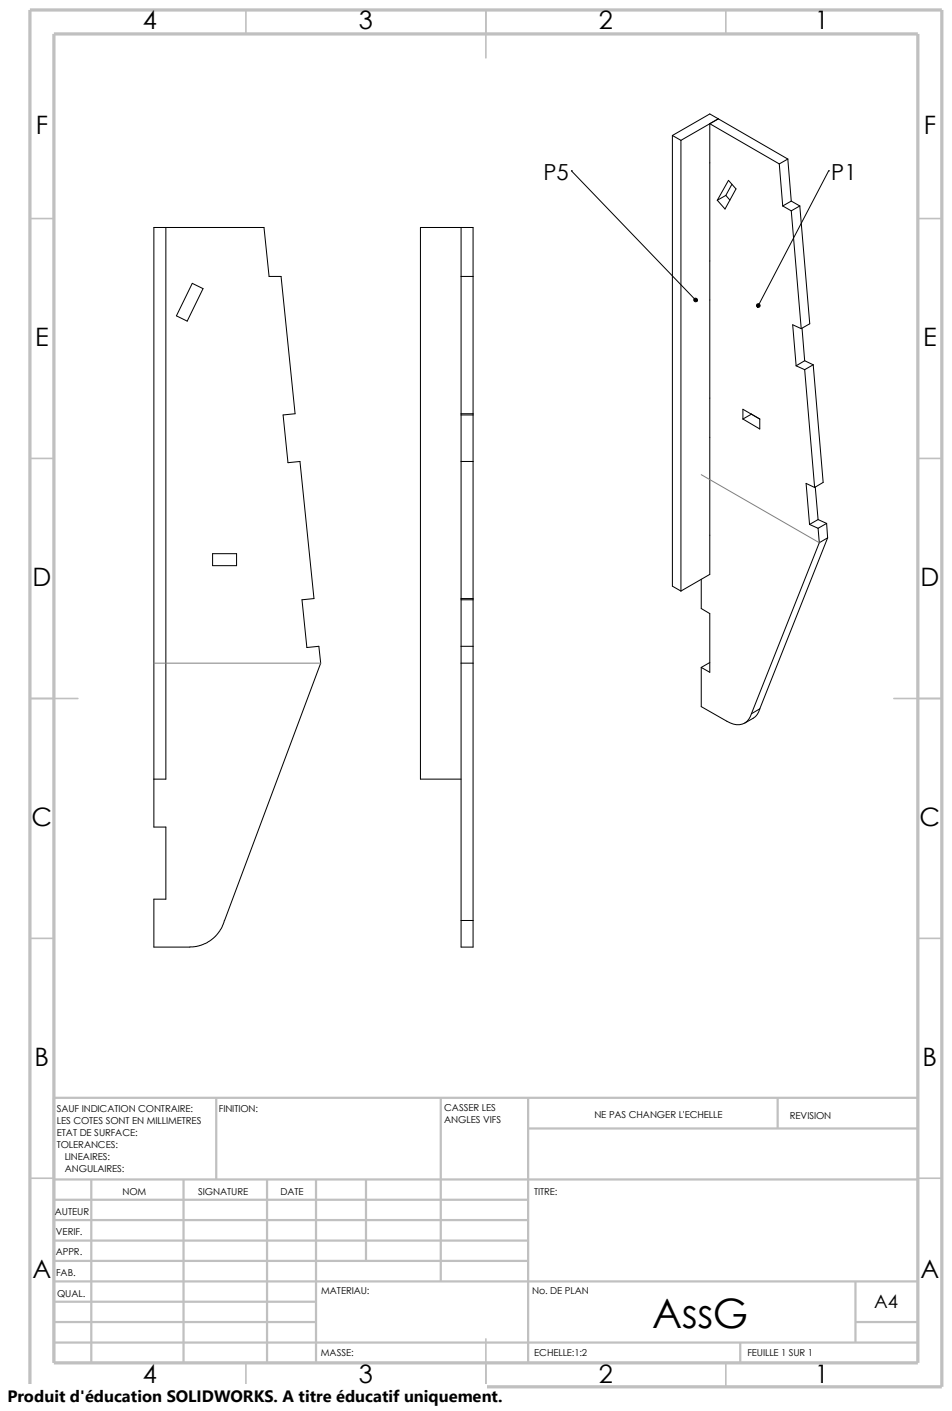
[picture p98: page 1]
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

NOM | SIGNATURE | DATE | TITRE:

AUTEUR
VERIF.
APPR.

No. DE PLAN
AssG

Produit d'éducation SOLIDWORKS. A titre éducatif uniquement.
