JeanSOUDIER/PRG_GE2_HC/Mecanique/Mise_En_Plan/P1.pdf

40,92

4,42

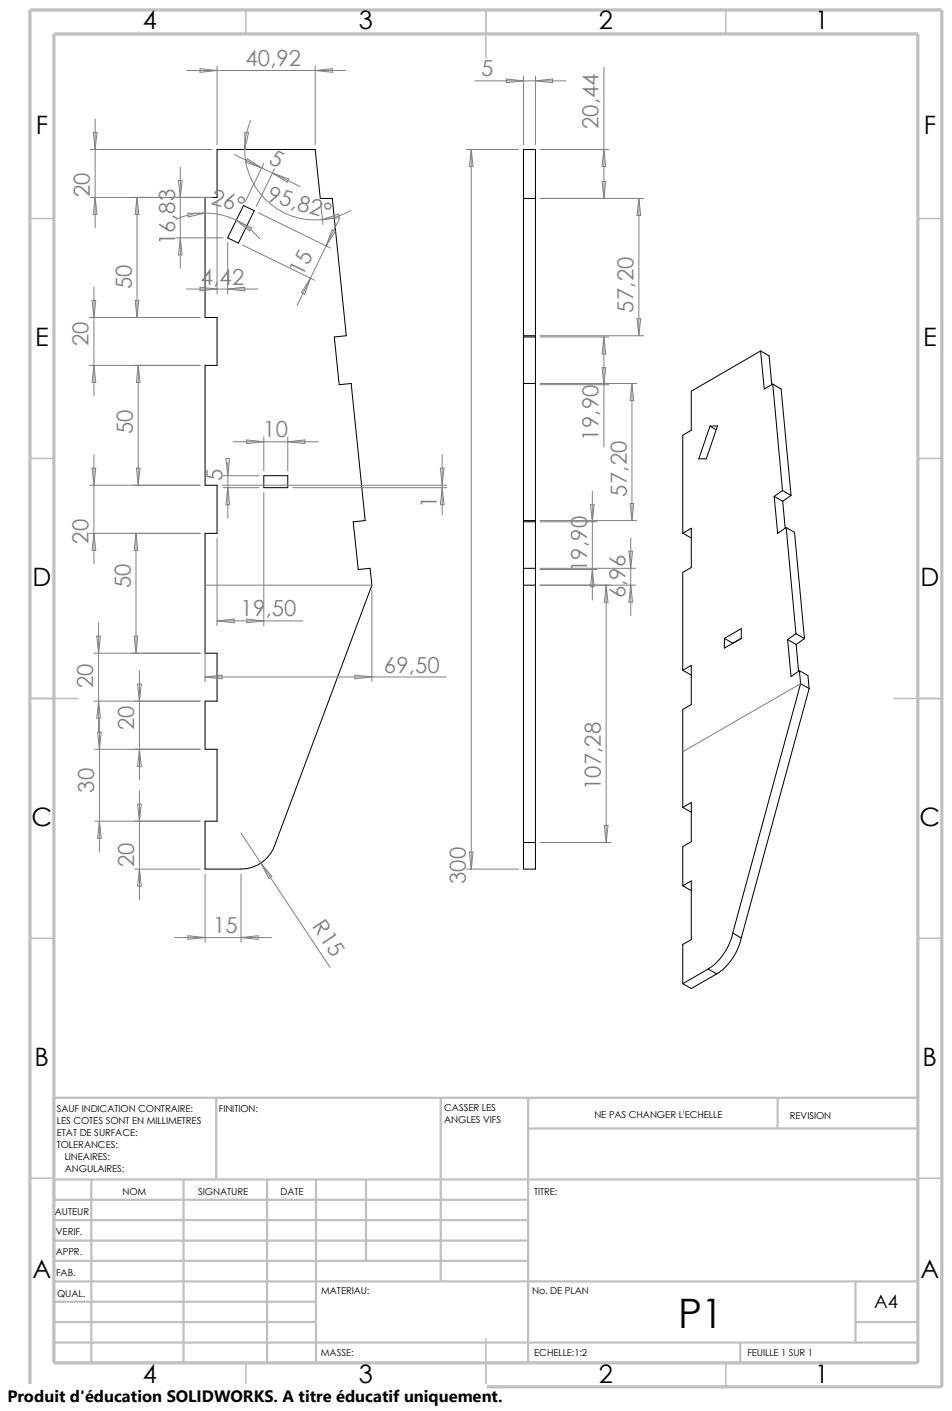
[picture p100: page 1]
ECHELLE:1:2; FEUILLE 1 SUR 1; MASSE:; NE PAS CHANGER L'ECHELLE; REVISION; MATERIAU:; No. DE PLAN; FAB.; QUAL.; FINITION:; ANGLES VIFS; CASSER LES

SAUF INDICATION CONTRAIRE:
LES COTES SONT EN MILLIMETRES
ETAT DE SURFACE:
TOLERANCES:
LINEAIRES:
ANGULAIRES:

NOM | SIGNATURE | DATE | TITRE:

AUTEUR
VERIF.
APPR.

Produit d'éducation SOLIDWORKS. A titre éducatif uniquement.
