JeanSOUDIER/PRG_GE2_HC/(list of files, drawings)

Other design files:
pcb/carte_onduleur_v4.pdsprj
pcb/carte_transistors_v2.pdsprj
Programmation/DsPIC.X/New Project.pdsprj
Programmation/PIC.X/New Project.pdsprj
Simulation/Proteus/ge2_led.pdsprj
Simulation/Proteus/mes_cur.pdsprj
Simulation/Proteus/test_protection_alim.pdsprj
