JeanSOUDIER/PRG_GE2_HC/(commit log)

2020-03-24 second commit
    [Assemblage1.SLDASM, Assemblage1.STEP, Header Pins 10-Way Single Row.SLDPRT, New Project.pdsprj, PIC.X.production.obj, bluetooth.pdsprj, carte_alim.pdsprj, carte_alim_v3.pdsprj]
2020-03-25 modif servo + bat
    [PIC.X.production.obj]
2020-03-26 modif i2c fonctionnel
    [PIC.X.production.obj, carte_alim_v3.pdsprj, ge2_led.pdsprj]
2020-03-29 modif cartes !!!
    [carte_alim_v5.pdsprj, carte_commande.STEP, carte_commande.pdsprj, carte_onduleur.pdsprj]
2020-03-29 modif meca
    [=_[0_1_1_10].sldprt, =_[0_1_1_10]_2.sldprt, =_[0_1_1_11].sldprt, =_[0_1_1_11]_2.sldprt, =_[0_1_1_12].sldprt, =_[0_1_1_12]_2.sldprt, =_[0_1_1_13].sldprt, =_[0_1_1_14].sldprt]
2020-03-29 modif code
    [PIC.X.production.obj]
2020-03-30 modif pcb
    [PIC.X.production.obj, carte_alim_v5.pdsprj, carte_commande.pdsprj, carte_onduleur.pdsprj]
2020-03-30 modif mid servo + pin en
    [PIC.X.production.obj]
2020-03-30 modif code fini
    [PIC.X.production.obj]
2020-03-31 modif adjust dspic
    [PIC.X.production.obj]
2020-03-31 modif PID hard
    [PIC.X.production.obj]
2020-03-31 code propre
    [PIC.X.production.obj]
2020-03-31 add comments
    [PIC.X.production.obj]
2020-04-03 add cao
    [AssBase.SLDASM, AssD.SLDASM, AssG.SLDASM, AssMot.SLDASM, AssServo.SLDASM, AssStruct.SLDASM, P1.SLDPRT, P10.SLDPRT]
2020-04-06 modif cao + prog + rapport
    [AssStruct.SLDASM, PIC.X.production.obj]
2020-04-07 modif pcb + meca
    [1.sldprt, 10.sldasm, 10_2.sldasm, 11.sldasm, 11.sldprt, 124.sldasm, 13.sldasm, 135.sldasm]
2020-04-10 modif meca + prog
    [PIC.X.production.obj, carte_alim_v8.pdsprj, carte_commande.pdsprj, carte_onduleur_v3.pdsprj, carte_transistors.pdsprj]
2020-04-12 modif simu
    [AssBase.SLDASM, AssD.SLDASM, AssG.SLDASM, AssGrillage.SLDASM, AssPhare.SLDASM, AssProtec.SLDASM, AssStructSimu.SLDASM, AssStructSimu.SLDPRT]
2020-04-15 modif cao
    [AssBase.SLDASM, AssCarte.SLDASM, AssCosse.SLDASM, AssEntretoise.SLDASM, AssGouv.SLDASM, AssGouv.SLDPRT, AssGouv.STL, AssMpu.SLDASM]
2020-04-20 video aero
    [AssGoPro.SLDASM]
2020-04-27 add mise en plan
    [AssProtec.SLDDRW, AssStructSimu.SLDDRW, AssToitMot.SLDDRW, AssTotale.SLDDRW, P1.SLDDRW, P10.SLDDRW, P11.SLDDRW, P12.STL]
2020-04-27 add mise en plan 2
    [AssBase.SLDDRW, AssCarte.SLDDRW, AssD.SLDDRW, AssG.SLDDRW, AssGouv.SLDDRW, AssLogo - logo1-1.STL, AssLogo - logo2-1.STL, AssPhare.SLDDRW]
2020-04-28 modif CAO + test simu proteus
    [AssBase.SLDASM, AssD.SLDASM, AssEntretoise.SLDASM, AssG.SLDASM, AssGouv.SLDASM, AssLogo.SLDASM, AssPhare.SLDASM, AssProtec.SLDASM]
2020-04-28 add vidéo
    [PIC.X.production.obj]
2020-04-29 modif PCB + simu + code moteur + comment
    [carte_alim_v8.pdsprj, carte_alim_v9.pdsprj, carte_commande.pdsprj, carte_commande_v2.pdsprj, carte_onduleur_v3.pdsprj, carte_onduleur_v4.pdsprj, carte_transistors.pdsprj, carte_transistors_v2.pdsprj]
2020-05-19 modif meca + rapport
    [1.sldprt, 10.sldasm, 10.sldprt, 100.sldasm, 102.sldasm, 105.sldasm, 107.sldasm, 109.sldasm]
2020-05-29 modif rapport
    [ge2_led.pdsprj, mes_cur.pdsprj, test_protection_alim.pdsprj]
